joaovic-tech/IoT-Access-Control-ESP32/README.md

---
Project: IoT-Access-Control-ESP32
Description: INTERNET DAS COISAS (IOT) E INTELIGÊNCIA ARTIFICIAL APLICADA À DETECÇÃO E CLASSIFICAÇÃO DE ACESSOS EM AMBIENTES PÚBLICOS E PRIVADOS.
Purpose: TCC - Artigo científico
Acthor: João Victor Carvalho Alves
---





## 📌 Sobre o Projeto

Este repositório contém os artefatos de código e documentação técnica do meu Trabalho de Conclusão de Curso (TCC) em Engenharia de Software.

O projeto propõe uma solução de **Segurança Patrimonial Inteligente** utilizando IoT e Inteligência Artificial. Diferente de sistemas tradicionais que apenas gravam imagens, este sistema utiliza **Computação na Borda (Edge Computing)** e **Análise Contextual** para detectar, identificar e decidir sobre a permissão de acesso em tempo real.

### 🚀 Funcionalidades Principais

- **Detecção de Movimento (PIR):** Ativação inteligente para economia de energia e banda (Wake-on-Event).
- **Reconhecimento Facial:** Validação de identidade utilizando biblioteca `face_recognition` e OpenCV.
- **Motor de Regras (TBAC):** Controle de acesso baseado em horários e grupos (ex: Aluno Fundamental vs. Médio).
- **Comunicação MQTT:** Protocolo leve para transmissão de dados e imagens.

## 📂 Estrutura do Repositório (atual)

```bash
/
├── docs/              # Diagramas e Documentação Técnica
└── README.md
```

## 📄 Artigo Científico

O artigo completo detalhando a metodologia, resultados e fundamentação teórica estará disponível em breve.

- Status: 📝 Em escrita (Etapa de Desenvolvimento do Protótipo)
- Link: [Pendente - Aguardando Publicação](#)

## 📝 Licença

Este projeto é licenciado sob a licença [GPL-3.0 license](./LICENSE).
