joaovic-tech/IoT-Access-Control-ESP32/code/edge_manager/READE.md

# Edge Manager

Arquivo destinado ao código fonte do dispositivo IOT, compostos pelos seguintes periféricos:

1. ESP32-CAM
2. ESP32-CAM-MB
3. Sensor PIR
