joaovic-tech/IoT-Access-Control-ESP32/TCC_word/TCC_ALVES_EtapaFinal_2026.docx

# INTERNET DAS COISAS (IOT) E INTELIGÊNCIA ARTIFICIAL APLICADA À DETECÇÃO E CLASSIFICAÇÃO DE ACESSOS EM AMBIENTES PÚBLICOS E PRIVADOS

INTERNET OF THINGS (IOT) AND ARTIFICIAL INTELLIGENCE APPLIED TO THE DETECTION AND CLASSIFICATION OF ACCESSES IN PUBLIC AND PRIVATE ENVIRONMENTS

ALVES, João Victor Carvalho

FERRARI, Allan Christian Krainski

# Resumo

Este artigo apresenta o desenvolvimento e a análise de um protótipo de monitoramento e classificação de acessos que integra Internet das Coisas e reconhecimento facial. A pesquisa aplicada combina desenvolvimento experimental, inspeção da implementação e análise de registros de funcionamento. O dispositivo utiliza ESP32-CAM, câmera OV2640 e sensor PIR, com alimentação por baterias 18650 e conversor LM2596. O firmware transmite vídeo MJPEG diretamente ao aplicativo Android e envia quadros JPEG a um servidor local em Python, com FastAPI, OpenCV e face_recognition. O aplicativo, desenvolvido em Kotlin e Jetpack Compose, permite configurar câmeras, gerenciar pessoas e cômodos e consultar detecções. A identificação facial é estatística; a autorização por cômodo é calculada por regras determinísticas, com uma exceção quando o cômodo não é resolvido. As demonstrações registradas ilustram reconhecimento autorizado e não autorizado, rosto desconhecido e presença sem rosto identificável. Uma varredura histórica com um par genuíno e cinco pares impostores apresentou duas aceitações incorretas no limiar 0,60, sem permitir estimativas generalizáveis de desempenho. A versão implementada mantém limitações de autenticação, transporte sem cifragem, vivacidade opcional e ausência de gravação no cartão SD. Não foram estabelecidas medidas de latência fim a fim, autonomia ou custo total. Os resultados sustentam a demonstração funcional do protótipo e indicam a necessidade de ampliar a avaliação antes de sua utilização como mecanismo de segurança física.

Palavras-chave: internet das coisas; inteligência artificial; controle de acesso; reconhecimento facial; ESP32-CAM.

# Abstract

This article presents the development and analysis of an access monitoring and classification prototype that combines the Internet of Things and facial recognition. The applied research combines experimental development, implementation inspection, and analysis of operating records. The device uses an ESP32-CAM, an OV2640 camera, and a PIR sensor, powered by 18650 batteries and an LM2596 converter. Its firmware streams MJPEG video directly to an Android application and sends JPEG frames to a local Python server running FastAPI, OpenCV, and face_recognition. The application, developed with Kotlin and Jetpack Compose, supports camera configuration, people and room management, and detection monitoring. Facial identification is statistical, whereas room authorization follows deterministic rules, with an exception when the room cannot be resolved. Recorded demonstrations illustrate authorized and unauthorized recognized individuals, unknown faces, and presence without an identifiable face. A historical threshold sweep involving one genuine pair and five impostor pairs produced two incorrect acceptances at a threshold of 0.60, without supporting generalizable performance estimates. The implementation retains limitations involving authentication, unencrypted transport, optional liveness verification, and lack of SD card recording. End-to-end latency, battery life, and total cost have not been established. The results support a functional prototype demonstration and indicate that broader evaluation is required before deployment for physical security.

Keywords: internet of things; artificial intelligence; access control; facial recognition; ESP32-CAM.

# 1 INTRODUÇÃO

A segurança de ambientes físicos, sejam eles públicos ou privados, tem passado por uma transformação elevada nas últimas décadas. Historicamente dependente de barreiras físicas estáticas e da vigilância humana constante, o setor de segurança enfrenta agora o desafio de integrar tecnologias digitais emergentes para lidar com ameaças cada vez mais complexas e dinâmicas. A convergência entre a conectividade onipresente da Internet das Coisas (Internet of Things — IoT) e a capacidade analítica da Inteligência Artificial (IA) oferece uma oportunidade sem precedentes para redefinir os conceitos de monitoramento e controle de acesso.

Este trabalho enquadra-se na Revolução Industrial 4.0, na qual a digitalização dos processos físicos permite a criação de ambientes inteligentes (smart environments). O tema central é a aplicação de sistemas embarcados conectados e algoritmos de aprendizado de máquina para automatizar a detecção, identificação e classificação de indivíduos em pontos de acesso. Diferentemente dos sistemas de Circuito Fechado de Televisão (CFTV) tradicionais, que apenas registram eventos para análise forense posterior, a solução proposta busca uma abordagem proativa: identificar e classificar o acesso em tempo real, permitindo uma resposta imediata a potenciais riscos.

A problemática central reside nas limitações da vigilância visual contínua. A atenção do operador, as condições de observação e a quantidade de imagens influenciam a identificação de eventos. O estudo de Tickner e Poulton (1973) integra a discussão sobre monitoramento de imagens de vigilância. No controle de acesso, a automação pode apoiar a observação e a organização dos registros, mas acrescenta erros de percepção algorítmica que também precisam ser avaliados.

Diante deste cenário, este trabalho propõe o desenvolvimento e a análise de um dispositivo IoT integrado a um sistema de IA, capaz de monitorar entradas e saídas de forma autônoma. O objetivo geral é criar um protótipo funcional que realize a detecção de movimento, a captura de imagens e a classificação automática dos acessos entre pessoas reconhecidas, com autorização avaliada separadamente, e pessoas não reconhecidas, disponibilizando o resultado em tempo real ao responsável por meio de um aplicativo móvel. A proposta visa demonstrar que é possível elevar o nível de segurança e reduzir as falhas humanas através da automação tecnológica de baixo custo. Do ponto de vista econômico, sistemas de segurança biométrica comerciais costumam ter custos elevados, proibitivos para pequenas empresas ou residências populares; a utilização de hardware acessível como o ESP32-CAM democratiza o acesso a tecnologias de ponta. Do ponto de vista social e de segurança, a automação reduz o tempo de resposta a incidentes e mitiga o erro humano, proporcionando um monitoramento ininterrupto que não sofre de fadiga ou distração. Tecnicamente, o projeto justifica-se pela exploração da integração entre sistemas embarcados limitados e o processamento em servidor, um desafio relevante na engenharia de computação atual.

Para concretizar a proposta, foram delineados os seguintes objetivos específicos: fundamentar teoricamente os conceitos de IoT, IA, Visão Computacional e as normas da LGPD aplicáveis; desenvolver a arquitetura de hardware utilizando o módulo ESP32-CAM, o sensor PIR de presença e uma fonte autônoma composta por baterias 18650 e regulador LM2596; implementar o firmware de controle para captura de imagens e comunicação via protocolo HTTP, incluindo os servidores embarcados de API e de vídeo; desenvolver um servidor de processamento utilizando a linguagem Python, o framework FastAPI e as bibliotecas OpenCV e face_recognition para detecção e reconhecimento facial; construir um aplicativo Android em Kotlin para cadastro de pessoas, cadastro de cômodos, configuração dos dispositivos e acompanhamento das detecções; e analisar os resultados obtidos em termos de precisão, tempo de resposta e viabilidade, discutindo as implicações de segurança e privacidade.

Uma decisão de projeto merece destaque desde a introdução, por diferenciar este trabalho de implementações correntes: a decisão de autorizar ou negar o acesso não é tomada por um modelo de aprendizado de máquina. A IA atua exclusivamente na camada de percepção — reconhecer o rosto, verificar a vivacidade da captura, detectar a presença de alguém no quadro — e na camada de interface, por meio de um assistente em linguagem natural destinado ao administrador. A autorização propriamente dita é resolvida por uma tabela determinística, auditável e reproduzível. A seção 2.5 apresenta o fundamento dessa escolha e a seção 3.5.3 detalha sua implementação.

Este artigo está organizado em cinco seções. Após esta introdução, a seção 2 apresenta a Fundamentação Teórica, revisando a literatura sobre os pilares tecnológicos e legais do projeto. A seção 3, Metodologia, detalha os materiais, os métodos e a implementação prática do sistema. A seção 4, Resultados e Discussão, expõe os dados coletados nos testes em ambiente real e analisa o desempenho do sistema. Por fim, a seção 5 traz as Considerações Finais, sintetizando as conclusões e sugerindo trabalhos futuros.

# 2 FUNDAMENTAÇÃO TEÓRICA

A construção de um sistema de segurança inteligente exige a compreensão profunda de diversas áreas do conhecimento. Esta seção explora os conceitos de Internet das Coisas, Inteligência Artificial aplicada à visão, os paradigmas de segurança eletrônica, o arcabouço legal brasileiro de proteção de dados e, por fim, os limites do uso de modelos de linguagem em decisões críticas.

## 2.1 A revolução da Internet das Coisas (IoT)

A IoT não é apenas uma tendência tecnológica, mas uma mudança estrutural na forma como o mundo físico interage com o mundo digital.

### 2.1.1 Definições e conceitos acadêmicos

O termo foi cunhado por Kevin Ashton em 1999, mas o conceito evoluiu significativamente. Segundo Atzori, Iera e Morabito, em seu artigo seminal The Internet of Things: A Survey (Atzori et al., 2010), a IoT pode ser compreendida sob três visões: orientada a coisas (focada em sensores e etiquetas RFID), orientada à internet (focada em protocolos IP) e orientada à semântica (focada no significado dos dados). A definição consolidada refere-se a uma infraestrutura de rede global, na qual objetos físicos e virtuais são descobertos e integrados de forma transparente.

Dave Evans, em white paper para a Cisco, descreve a IoT como o ponto na história em que mais "coisas" ou objetos estavam conectados à Internet do que pessoas, estimando que bilhões de dispositivos estariam interconectados, gerando dados que poderiam "mudar tudo", desde a gestão urbana até a segurança pessoal (Evans, 2011).

### 2.1.2 Arquitetura de sistemas IoT

Para fins de segurança e vigilância, a arquitetura de IoT é geralmente dividida em camadas, conforme descrito na literatura técnica.

A Camada de Percepção (Perception Layer) constitui a base física do sistema, incluindo sensores como o PIR HC-SR501 e dispositivos de captura como a câmera OV2640 no ESP32-CAM. Sua função é coletar dados brutos do ambiente e transformá-los em sinais digitais.

A Camada de Rede (Network/Transport Layer) é responsável pela transmissão confiável dos dados coletados para o sistema de processamento, utilizando tecnologias como Wi-Fi, Bluetooth, Zigbee ou LoRaWAN. No contexto deste projeto, o foco é a transmissão de imagens via Wi-Fi sobre a pilha TCP/IP, com o protocolo HTTP na camada de aplicação.

A Camada de Processamento (Processing Layer) é onde os dados são armazenados e analisados, podendo ocorrer na nuvem (Cloud Computing) ou na borda (Edge Computing). Neste trabalho adotou-se uma posição intermediária — um servidor local na própria rede da residência —, escolha crítica para a segurança, pois reduz a latência, elimina a dependência de conectividade externa constante e mantém o dado biométrico dentro do perímetro do titular, ponto que a seção 2.4 retoma sob a ótica da LGPD.

A Camada de Aplicação (Application Layer) representa a interface com o usuário final, na qual os alertas são recebidos e as decisões são tomadas. Neste projeto, essa camada é o aplicativo Android descrito na seção 3.6.

### 2.1.3 Protocolos de comunicação: o modelo requisição-resposta do HTTP

A escolha do protocolo de comunicação é crucial para a eficiência do sistema.

O protocolo HTTP (Hypertext Transfer Protocol) é amplamente utilizado para transmissão de imagens e streaming de vídeo (MJPEG) devido à sua simplicidade e à compatibilidade nativa com navegadores web e com bibliotecas cliente de praticamente qualquer linguagem. Sua principal desvantagem reconhecida na literatura é o overhead de cabeçalho e o custo de estabelecer conexões TCP quando elas não são reutilizadas, o que pode aumentar a latência e o consumo de energia em cenários de envio muito frequente. Estudos comparativos entre protocolos de IoT registram, para cargas pequenas e periódicas, vantagem do modelo publica-assina sobre o modelo requisição-resposta (Amirkhanov et al., 2025; Flespi Platform, 2017).

Esse overhead, entretanto, precisa ser avaliado contra o padrão de tráfego real da aplicação. O sistema descrito neste trabalho não transmite telemetria contínua de poucos bytes: ele transmite um quadro JPEG completo por evento de presença, com intervalo mínimo de dez segundos entre disparos, e um fluxo de vídeo contínuo que é, por natureza, uma única resposta HTTP longa. Nesse regime, o custo relativo do cabeçalho tende a ser menor diante do payload da imagem, embora não tenha sido quantificado no protótipo, e as vantagens do HTTP passam a predominar:

- Transporte nativo de cargas binárias grandes. O envio da imagem usa multipart/form-data, formato que o servidor decodifica sem qualquer protocolo de fragmentação e remontagem escrito manualmente.

- Vídeo ao vivo sem intermediários. O streaming MJPEG é uma resposta multipart/x-mixed-replace mantida aberta pelo próprio dispositivo. O aplicativo consome o fluxo diretamente do ESP32-CAM, sem que o vídeo trafegue pelo servidor de reconhecimento — o que mantém a latência da imagem ao vivo dependente apenas da rede local.

- Contrato explícito e inspecionável. Cada operação é uma rota com método, parâmetros e resposta definidos, verificável com um cliente HTTP comum durante o desenvolvimento e a depuração.

- Ausência de um componente intermediário. O modelo publica-assina exige um broker — um terceiro processo que precisa estar instalado, configurado, em execução e disponível para que qualquer mensagem trafegue. Em uma instalação residencial, esse componente adicional representa mais um ponto de falha e mais uma superfície de configuração.

- Comunicação bidirecional imediata. O acionamento do relé de acesso, o controle do LED de iluminação e a leitura do estado do dispositivo são requisições dirigidas ao ESP32-CAM, que responde de imediato, sem necessidade de tópicos separados de comando e de retorno.

Por essas razões, este trabalho adota o HTTP em toda a comunicação entre as três camadas do sistema. A seção 3 detalha as rotas, os métodos, os payloads e as portas efetivamente implementados.

Não foi realizada medição de latência fim a fim do protótipo. Tempos de outros estudos não substituem a medição entre o disparo do PIR e o registro da detecção.

## 2.2 Inteligência Artificial e Visão Computacional

A integração da IA transforma câmeras passivas em sensores inteligentes capazes de "entender" a cena.

### 2.2.1 Conceitos de IA segundo Russell e Norvig

Stuart Russell e Peter Norvig, em sua obra clássica Artificial Intelligence: A Modern Approach (Russell; Norvig, 2010), definem IA não apenas como a simulação da inteligência humana, mas como o estudo de agentes racionais. Um agente é qualquer coisa que percebe seu ambiente via sensores e age sobre esse ambiente através de atuadores.

No contexto deste projeto, o sistema de segurança é um "agente racional" que percebe a presença (sensor PIR), captura o estado do mundo (câmera OV2640) e age (aciona o relé da trava ou registra o evento no histórico) para maximizar sua medida de desempenho (segurança e conveniência).

### 2.2.2 Processamento digital de imagens e Visão Computacional

A Visão Computacional é a subárea da IA que lida com a interpretação de dados visuais. Segundo Gonzalez e Woods (2010), em Processamento Digital de Imagens, o processo pode ser dividido em fases fundamentais: aquisição da imagem, que ocorre via captura pelo sensor OV2640; pré-processamento, referente à melhoria da imagem (ajuste de brilho e contraste, conversão de espaço de cor, redimensionamento) para facilitar a análise; segmentação, que corresponde ao isolamento dos objetos de interesse — neste caso, a face — do fundo da imagem; representação e descrição, relativa à extração de características (features) que tornam aquele objeto único; e reconhecimento e interpretação, que consiste na atribuição de um rótulo (identidade) ao objeto com base em seus descritores.

Richard Szeliski, em Computer Vision: Algorithms and Applications (Szeliski, 2010), complementa que os algoritmos modernos de visão dependem fortemente de aprendizado de máquina estatístico para realizar o reconhecimento robusto em ambientes não controlados (variações de luz, pose e expressão). Essa dependência tem consequência prática direta neste trabalho: como a seção 4.6 documenta, a orientação física com que a câmera é instalada altera o resultado do detector, porque os modelos foram treinados sobre rostos aproximadamente verticais.

### 2.2.3 Algoritmos de detecção e reconhecimento facial

Para a execução prática, é essencial distinguir entre detecção e reconhecimento. A detecção facial consiste em encontrar onde está o rosto na imagem. O algoritmo de Viola e Jones (2001), baseado em cascatas de classificadores sobre características de Haar, é um método clássico, extremamente rápido e leve, adequado para pré-processamento, embora propenso a falsos positivos em cenários complexos. Redes Neurais Convolucionais (CNNs), como o MTCNN ou modelos baseados em YOLO (You Only Look Once), oferecem precisão superior, detectando faces em diversos ângulos e escalas, mas exigem maior poder computacional.

Uma alternativa de custo intermediário é o detector baseado em Histograma de Gradientes Orientados (HOG) implementado na biblioteca Dlib (King, 2009), adotado neste trabalho. Ele é substancialmente mais robusto que as cascatas de Haar e ordens de magnitude mais barato que um detector neural executado em CPU — característica decisiva para um servidor doméstico sem GPU, conforme a medição comparativa apresentada na seção 3.5.2.

O reconhecimento facial, por sua vez, busca identificar quem é a pessoa. Métodos tradicionais como Eigenfaces (PCA) e Fisherfaces (LDA) foram amplamente substituídos por modelos de aprendizado profundo como o FaceNet (Schroff et al., 2015) ou a rede residual da Dlib. Esta última mapeia uma face em um vetor de 128 dimensões, no qual a distância euclidiana entre vetores corresponde à dissimilaridade facial, alcançando acurácia superior a 99% no benchmark Labeled Faces in the Wild (LFW). É importante registrar, contudo, que essa acurácia é obtida sobre um conjunto de avaliação padronizado e não se transfere automaticamente para um sistema instalado em campo, com poucas amostras por pessoa e iluminação não controlada — ponto que a seção 4.4 documenta com medições próprias.

## 2.3 Segurança eletrônica e controle de acesso

O controle de acesso físico visa garantir que apenas pessoas autorizadas entrem em um determinado espaço.

### 2.3.1 Paradigma de segurança física e "Defesa em Profundidade"

A segurança patrimonial baseia-se no conceito de "Defesa em Profundidade" (Defense in Depth), que prega a utilização de múltiplas camadas de segurança redundantes. O controle de acesso automatizado atua como uma barreira de triagem crítica. Diferentemente de chaves físicas, que podem ser copiadas, ou de cartões RFID, que podem ser roubados, a biometria facial vincula o acesso intrinsecamente ao indivíduo, elevando o nível de segurança (fator "o que você é" vs. "o que você tem").

O princípio da defesa em profundidade orienta a combinação de reconhecimento facial, autorização cadastral e restrição por cômodo. No protótipo, entretanto, a verificação de vivacidade é opcional e vem desabilitada; quando não produz um resultado, não impede a autorização. A ausência de um cômodo resolvido também preserva a chave mestra de autorização. Essas exceções impedem afirmar que todas as camadas precisam aprovar explicitamente cada acesso.

### 2.3.2 Métricas de desempenho biométrico

A eficácia de um sistema biométrico é avaliada estatisticamente. O FAR (False Acceptance Rate) representa a probabilidade de o sistema aceitar incorretamente uma pessoa não autorizada; em segurança, o objetivo primário é minimizar o FAR. O FRR (False Rejection Rate) representa a probabilidade de o sistema rejeitar incorretamente uma pessoa autorizada; um FRR alto causa inconveniência e frustração ao usuário. A Curva ROC (Receiver Operating Characteristic) representa graficamente a relação entre a taxa de verdadeiros positivos e a de falsos positivos. O ajuste do limiar de sensibilidade (threshold) do algoritmo move o sistema ao longo dessa curva, trocando conveniência (baixo FRR) por segurança (baixo FAR). O ponto em que as duas taxas se igualam é denominado EER (Equal Error Rate) e é frequentemente usado como número-resumo de um sistema biométrico.

Este trabalho realizou uma varredura empírica de limiar sobre as próprias amostras cadastradas, cujos resultados — e cujas limitações estatísticas — são apresentados na seção 4.4.

## 2.4 Aspectos legais: a LGPD e o tratamento de biometria

A implementação tecnológica não ocorre no vácuo jurídico. No Brasil, a Lei Geral de Proteção de Dados (Lei nº 13.709/2018) impõe diretrizes estritas.

A LGPD define dados biométricos — como a imagem facial utilizada para identificação única — como dados pessoais sensíveis (Art. 5º, II). O tratamento desses dados é vedado, exceto em hipóteses específicas (Art. 11), como:

- quando o titular ou seu responsável legal consentir, de forma específica e destacada, para finalidades específicas;

- sem fornecimento de consentimento, nas hipóteses de garantia da prevenção à fraude e à segurança do titular, nos processos de identificação e autenticação de cadastro em sistemas eletrônicos (Art. 11, II, "g").

A implantação requer definir finalidade e base legal aplicável, assegurar transparência e adotar medidas de segurança compatíveis com o tratamento de dados sensíveis. O art. 38 prevê que a ANPD pode determinar a elaboração de Relatório de Impacto à Proteção de Dados Pessoais (RIPD); não estabelece uma obrigação universal e automática para qualquer condomínio ou empresa. A escolha da base legal exige avaliar as condições do tratamento, sem presumir que o consentimento seja sempre a única hipótese admitida (Brasil, 2018).

Na configuração local, as amostras e os registros são persistidos em arquivos no computador servidor. Existe, contudo, uma integração opcional com Telegram que envia a fotografia e sua legenda a um serviço externo quando configurada. A localização do servidor, por si só, não assegura conformidade: é necessário considerar retenção, descarte, controle de acesso, publicação de imagens e eventuais transferências de dados.

O tráfego entre ESP32-CAM, servidor e aplicativo utiliza HTTP sem TLS. Isso descreve a implementação adotada, sem demonstrar impossibilidade técnica de cifragem no hardware. As rotas do servidor não implementam autenticação de administrador; no firmware, a proteção por token cobre apenas determinadas rotas de atuação e pode estar desabilitada. O armazenamento local e as regras de autorização não substituem a proteção das interfaces administrativas.

## 2.5 Análise contextual e os limites do uso de modelos de linguagem em decisões de acesso

Enquanto a Visão Computacional, discutida anteriormente, resolve o problema da percepção (identificar quem está no ambiente), a segurança moderna exige uma camada superior de inteligência capaz de interpretar o contexto (analisar se a presença daquele indivíduo é permitida naquele momento e local).

Segundo Russell e Norvig (2010), um agente inteligente não apenas percebe o ambiente através de sensores, mas atua sobre ele para alcançar um objetivo. No contexto deste trabalho, o "objetivo" é a segurança patrimonial. Para isso, o sistema deve operar não apenas com reconhecimento de padrões, mas também com inferência lógica e regras de conhecimento. Transformar o dado bruto ("rosto de João detectado") em informação semântica ("João, cujo cadastro libera apenas o próprio quarto, foi detectado na sala privada") permite aplicar restrições por local, pois o sistema passa a validar a detecção contra um conjunto de regras, aproximando-se do conceito de Computação Ciente de Contexto (Context-Aware Computing).

A questão relevante — e que constitui uma contribuição própria deste trabalho — é qual mecanismo deve produzir essa inferência. Uma versão anterior do sistema derivava a regra de acesso de uma observação em texto livre digitada no cadastro, interpretada por um modelo de linguagem executado localmente. O desenho foi abandonado após medição registrada durante o desenvolvimento: para a observação "Quarto do Antônio", o modelo respondeu com um campo de acesso total verdadeiro, o que liberaria aquela pessoa na casa inteira. Não se trata de defeito de um modelo específico, mas de uma incompatibilidade de natureza entre a ferramenta e a tarefa. Um controle de acesso físico exige que a mesma entrada produza sempre a mesma saída, que a regra vigente seja legível por um auditor humano e que a falha, quando ocorrer, ocorra no sentido restritivo. A geração de texto não constitui, por si só, uma garantia de observância dessas condições; por isso, a interpretação em linguagem natural foi retirada da decisão de acesso.

Adota-se, portanto, uma separação explícita de responsabilidades, que atravessa todo o restante deste artigo:

- A IA percebe. Reconhecimento facial, verificação de vivacidade e detecção de presença — tarefas estatísticas por natureza, nas quais o erro é inevitável e mensurável por FAR e FRR.

- A IA conversa. Um assistente em linguagem natural traduz perguntas do administrador em consultas ao histórico ou em propostas de mudança de configuração, submetidas à confirmação na interface antes de serem enviadas à API de aplicação de propostas.

- A IA não autoriza. A decisão de permitir ou negar um acesso é uma tabela determinística, apresentada na seção 3.5.3, que torna a regra explícita, mas não elimina falsas aceitações biométricas, falhas de configuração ou acesso indevido às APIs.

Essa arquitetura preserva o ganho semântico pretendido pela análise contextual sem transferir a um componente probabilístico a responsabilidade por uma decisão de consequência física irreversível.

# 3 METODOLOGIA

Esta seção descreve como o sistema foi efetivamente construído. Inicia pela visão geral da arquitetura e pelo diagrama de blocos que relaciona as três camadas (3.1); apresenta em seguida os materiais empregados no protótipo físico, com o detalhamento do módulo ESP32-CAM, do sensor PIR e do subsistema de alimentação autônoma (3.2); descreve o fluxo de dados que vai do disparo de presença até o veredito de acesso (3.3); detalha o firmware embarcado, incluindo a configuração da câmera, os dois servidores HTTP e a tarefa assíncrona de envio (3.4); apresenta o servidor de reconhecimento, seu contrato de rotas, o pipeline de visão computacional, o motor determinístico de decisão e os módulos complementares (3.5); descreve o aplicativo Android e suas telas (3.6); e encerra com o procedimento adotado nos testes (3.7).

Quanto à natureza, esta é uma pesquisa aplicada, de abordagem qualitativa e quantitativa, conduzida pelo método de desenvolvimento experimental: constrói-se um artefato funcional e observa-se seu comportamento em ambiente real, registrando medições sempre que o instrumental disponível permitiu.

## 3.1 Visão geral da arquitetura

A solução foi desenvolvida sobre uma arquitetura de IoT em três camadas: a Camada de Borda, responsável pela detecção de presença, captura e transmissão da imagem; a Camada de Servidor, responsável pelo processamento de Visão Computacional, pela persistência dos dados e pela decisão de acesso; e a Camada de Aplicação, o aplicativo Android que serve de painel de monitoramento e de interface de cadastro.

O fluxo foi projetado para minimizar a latência percebida pelo usuário e para manter o dado biométrico dentro da rede local. Duas decisões estruturais decorrem disso:

1. O vídeo ao vivo não passa pelo servidor Python. O aplicativo abre a conexão MJPEG diretamente contra o ESP32-CAM, na porta 81. O servidor de reconhecimento só recebe quadros isolados, quando há um evento a analisar.

2. O reconhecimento não ocorre na borda. A implementação não executa o modelo facial da Dlib no ESP32-CAM; o trabalho pesado é delegado ao servidor local, que dispõe de CPU e memória convencionais.

A Figura 1 apresenta o diagrama de blocos do sistema, com os protocolos e as portas de cada enlace.

Figura 1 – Diagrama de blocos da arquitetura do sistema

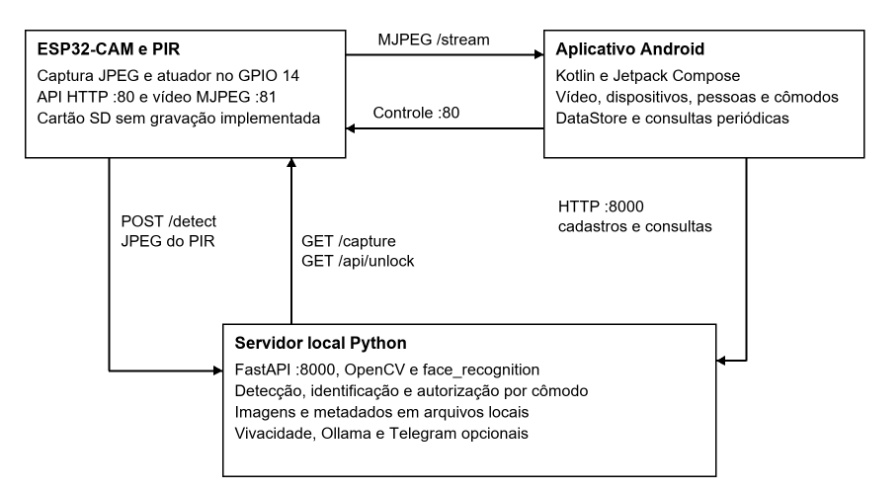
[picture p4: figure]

Fonte: o autor (2026).

## 3.2 Materiais: o hardware do protótipo

O protótipo foi montado com componentes de prateleira, de baixo custo e disponibilidade nacional. Esta subseção descreve cada um deles e o papel que desempenha no conjunto.

### 3.2.1 Módulo ESP32-CAM e gravador ESP32-CAM-MB

O núcleo do dispositivo é o módulo ESP32-CAM, na variante AI-Thinker. Trata-se de uma placa que reúne, em pouco mais de 27 × 40,5 mm, o microcontrolador ESP32 — SoC de dois núcleos com rádio Wi-Fi 802.11 b/g/n e Bluetooth integrados —, memória PSRAM externa, um conector para módulo de câmera, um leitor de cartão microSD e um LED branco de alta intensidade utilizável como iluminação auxiliar. As Figuras 2 e 3 mostram as duas faces da placa efetivamente utilizada.

Figura 2 – Módulo ESP32-CAM — face da câmera OV2640 e do LED de iluminação

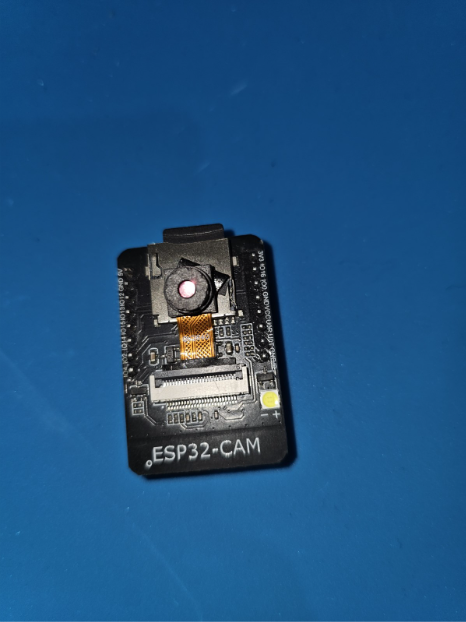
[picture p5: figure]

Fonte: o autor (2026).

Figura 3 – Módulo ESP32-CAM — face do módulo ESP32-S e da antena impressa

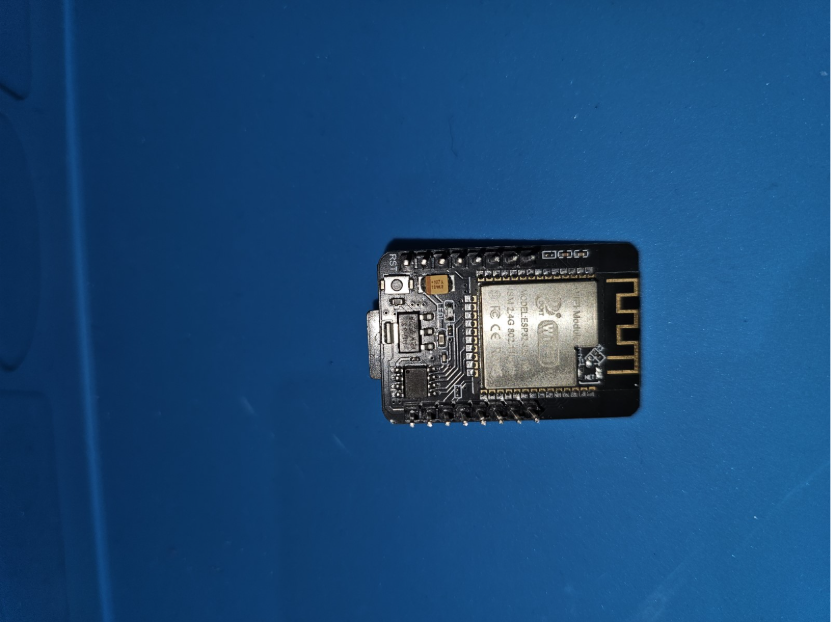
[picture p6: figure]

Fonte: o autor (2026).

A PSRAM é utilizada para os buffers de imagem e, preferencialmente, para o corpo multipart. Quando não é detectada, a configuração inicial solicita QVGA, um buffer em DRAM, qualidade JPEG 15 e captura CAMERA_GRAB_WHEN_EMPTY. Contudo, após inicializar o sensor, o código chama set_framesize(FRAMESIZE_VGA) incondicionalmente. Portanto, o retorno a QVGA não fica preservado ao final da inicialização, e a operação sem PSRAM precisa ser corrigida e validada antes de ser apresentada como modo degradado garantido.

A gravação do firmware é feita através da placa adaptadora ESP32-CAM-MB, que acopla-se ao ESP32-CAM pelos pinos de borda e fornece um conversor USB-serial CH340 e o circuito de auto-reset, dispensando o curto manual entre IO0 e GND a cada gravação. A Figura 4 mostra o conjunto montado.

Figura 4 – ESP32-CAM acoplado à placa gravadora ESP32-CAM-MB

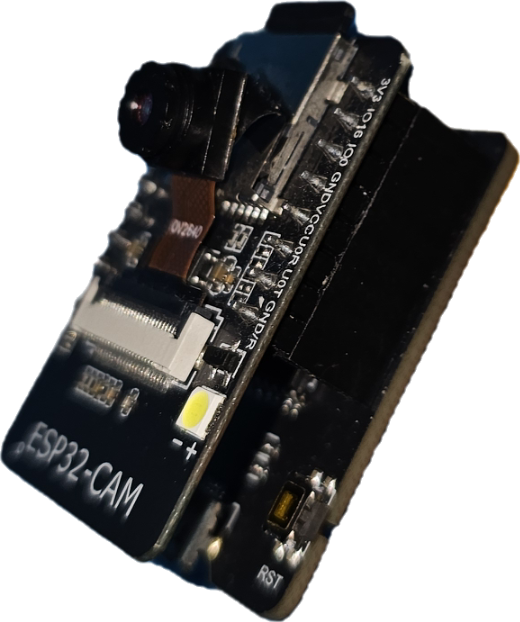
[picture p7: figure]

Fonte: o autor (2026).

O sensor de imagem é o OV2640, um sensor CMOS de 2 megapixels com compressão JPEG em hardware. A compressão embarcada é a razão pela qual um microcontrolador consegue transmitir vídeo: o quadro chega ao firmware já codificado, sem que a CPU precise realizar a compressão em software.

### 3.2.2 Sensor de presença PIR

A detecção de movimento é feita por um sensor PIR (Passive InfraRed), no formato do módulo HC-SR501. O sensor não emite energia: ele mede a radiação infravermelha do ambiente através de um elemento piroelétrico dividido em duas metades, sob uma lente de Fresnel que segmenta o campo de visão em zonas. Quando um corpo com temperatura distinta do fundo — tipicamente uma pessoa — atravessa a fronteira entre duas zonas, as metades do elemento recebem irradiâncias diferentes e a diferença de sinal é interpretada como movimento, elevando a saída digital do módulo a nível alto. A Figura 5 mostra o componente.

Figura 5 – Sensor de movimento e presença PIR

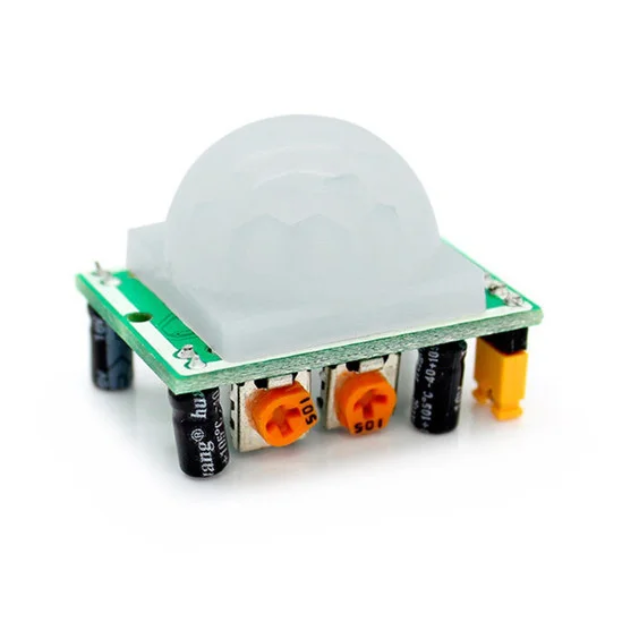
[picture p8: figure]

Fonte: https://www.eletrogate.com/sensor-de-movimento-presenca-pir. Acesso em: 30 ago. 2026.

A escolha do PIR como gatilho, em vez de análise contínua de vídeo, é uma decisão de eficiência: o reconhecimento facial só é executado quando há motivo físico para supor que existe alguém no ambiente, o que evita processamento e tráfego permanentes.

O sensor é ligado ao GPIO 13 do ESP32-CAM. Essa escolha de pino não é arbitrária e corrige um defeito observado em versão anterior do protótipo: o sensor estava declarado no firmware como GPIO 3, que no ESP32 corresponde ao pino RX0 da UART. Com a comunicação serial ativa para depuração, qualquer ruído elétrico na linha ou qualquer byte chegando pelo cabo USB era lido pelo código como transição do sensor, gerando disparos falsos e envios de imagem sem que houvesse ninguém no ambiente. A alteração remove a sobreposição entre o sinal do PIR e a recepção serial; não foi localizada uma série de medições que quantifique a eliminação de disparos falsos.

### 3.2.3 Alimentação: baterias 18650 e regulador LM2596

Para que o dispositivo não dependa de tomada, o protótipo é alimentado por duas células de íon-lítio 18650 montadas em suporte, com tensão nominal de 3,7 V e tensão de plena carga de 4,2 V por célula. Associadas em série, entregam entre 6,0 V e 8,4 V conforme o estado de carga — faixa que não pode ser aplicada diretamente ao ESP32-CAM.

A adequação de tensão é feita por um regulador *step-down* (*buck*) ajustável LM2596 DC-DC, mostrado na Figura 6. Trata-se de um conversor comutado que reduz a tensão de entrada a um valor de saída ajustável por trimpot, com capacidade nominal de até 3 A para o circuito integrado, condicionada ao dimensionamento e à dissipação do módulo. Duas propriedades justificam a escolha em vez de um regulador linear: a possibilidade de maior eficiência que a regulação linear — enquanto um regulador linear dissiparia a diferença de tensão inteiramente em calor, reduzindo drasticamente a autonomia das células —, e a estabilidade da saída ao longo da descarga, desde que exista margem entre a tensão de entrada e a saída ajustada; a regulação em toda a faixa de descarga não foi medida.

Figura 6 – Regulador de tensão ajustável LM2596 DC-DC

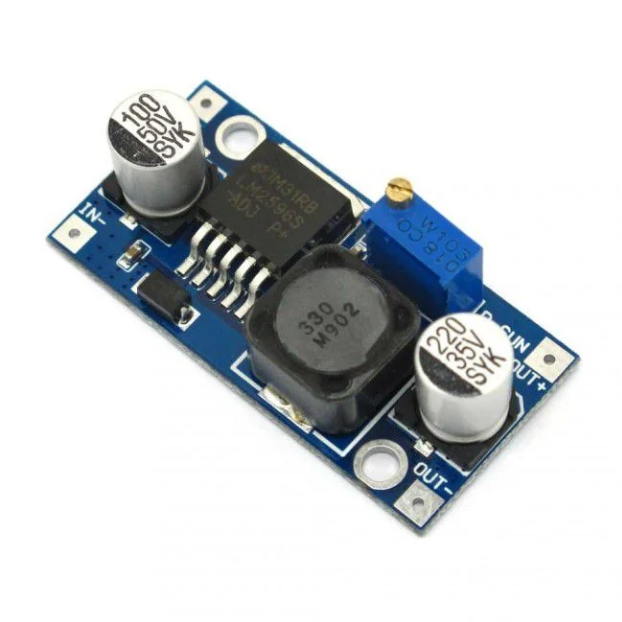
[picture p9: figure]

Fonte: https://www.eletrogate.com/modulo-regulador-de-tensao-step-down-lm2596. Acesso em: 30 ago. 2026.

A estabilidade da alimentação é requisito crítico e não apenas conveniência: o pico de corrente exigido pelo rádio Wi-Fi durante a transmissão é a causa mais comum de reinicializações espúrias em projetos com ESP32-CAM, e uma fonte incapaz de sustentá-lo produz falhas intermitentes de difícil diagnóstico.

A tensão efetivamente ajustada, a capacidade das células e a autonomia não foram medidas; a descrição do subsistema não estabelece desempenho energético.

### 3.2.4 Atuador de acesso e montagem

A liberação física é feita por um módulo de relé, comandado pelo GPIO 14. Também aqui a escolha do pino resolve um problema concreto: o GPIO 12 do ESP32 é um strapping pin (MTDI), lido durante a inicialização para definir a tensão de operação da memória flash. Com o relé conectado a ele, o nível presente no momento do boot impedia a placa de inicializar. O GPIO 14, correspondente ao sinal HS2_CLK do leitor de cartão — não inicializado pelo firmware atual —, não tem essa função de configuração e pode assumir qualquer nível durante a partida sem consequências.

Embora exista um cartão microSD de 2 GB instalado no ESP32-CAM, o firmware não inicializa SD ou SD_MMC e não grava vídeo ou eventos nesse cartão. Os GPIOs 13 e 14 utilizados pelo PIR e pelo relé também participam da interface SD_MMC, exigindo revisão da pinagem para acrescentar armazenamento. O vídeo atual é transmitido por MJPEG; o servidor persiste imagens isoladas com metadados. Transmissão ao vivo e gravação contínua são funcionalidades distintas.

O Quadro 1 consolida a pinagem do protótipo.

Quadro 1 – Pinagem do dispositivo IoT

Função | GPIO | Observação
Sensor PIR (saída digital) | 13 | Entrada, com debounce de 50 ms por software
Relé / trava de acesso | 14 | Evitado o GPIO 12 por ser strapping pin (MTDI)
LED branco de iluminação (flash) | 4 | Controlado por PWM (ledcWrite), intensidade 0–255
LED vermelho embutido | 33 | Active low; sinaliza o estado da conexão Wi-Fi

Fonte: o autor (2026).

As Figuras 7 e 8 mostram o protótipo montado. A montagem utiliza uma protoboard como base de interligação, com o sensor PIR fixado a uma haste de madeira por abraçadeiras, de modo a posicionar o elemento sensor acima do plano da placa e ampliar seu campo de visão. Na face posterior ficam o suporte das duas células 18650 e o módulo LM2596.

Figura 7 – Protótipo montado — vista frontal

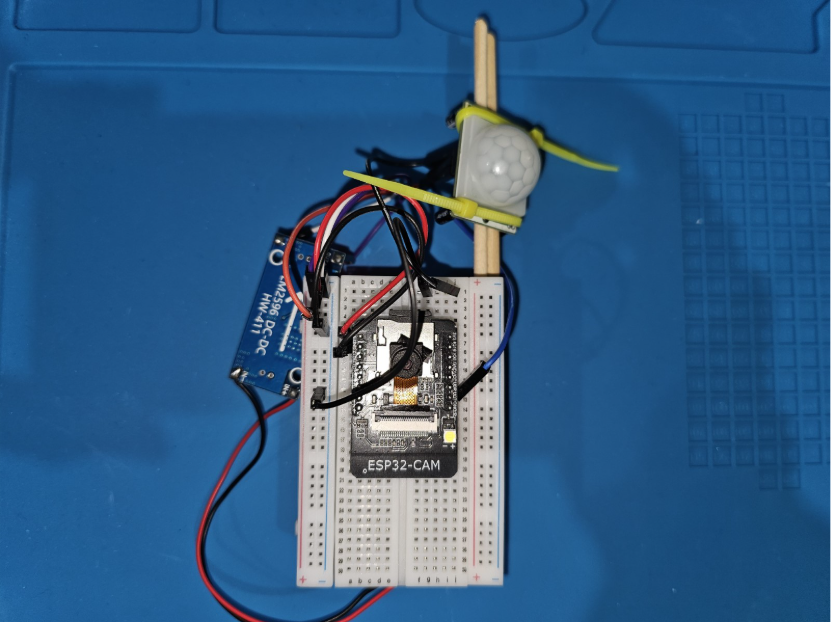
[picture p10: figure]

Fonte: o autor (2026).

Figura 8 – Protótipo montado — vista traseira, com o subsistema de alimentação

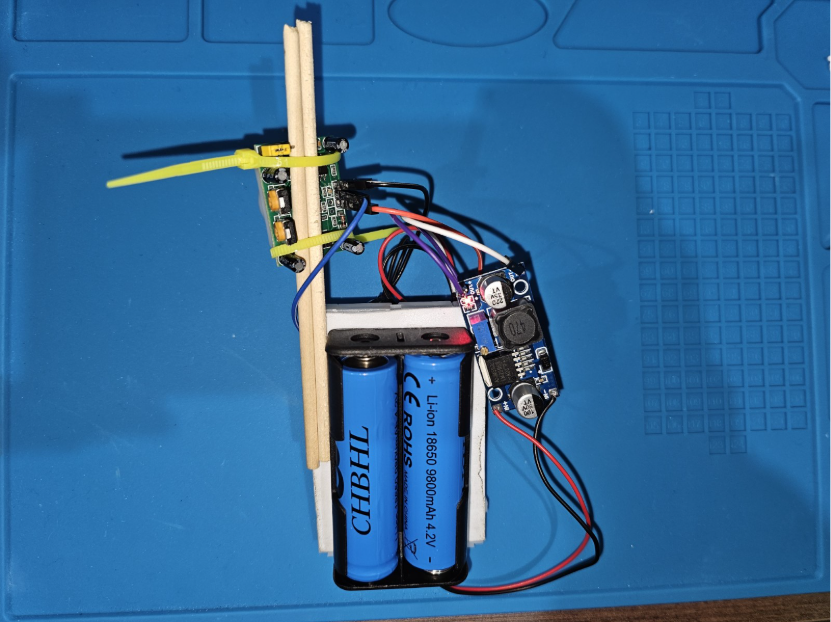
[picture p11: figure]

Fonte: o autor (2026).

Cabe registrar que se trata de uma montagem de bancada, destinada à validação funcional. Um encapsulamento definitivo, com fixação mecânica e proteção contra poeira e umidade, é apontado na seção 5 entre os trabalhos futuros.

## 3.3 Fluxo de dados e funcionamento

O funcionamento do sistema segue um fluxo determinístico, composto pelas etapas descritas a seguir.

1. Detecção de presença. O sensor PIR detecta variação de irradiância infravermelha e eleva a saída ligada ao GPIO 13. O laço principal do firmware amostra o pino continuamente e aplica debounce de 50 ms, contabilizando apenas as transições estáveis de nível baixo para alto (borda de subida).

2. Enfileiramento da captura. Reconhecida a borda de subida, e respeitado um intervalo de guarda de 10 segundos desde o último envio, o firmware sinaliza uma tarefa dedicada do FreeRTOS. O laço principal não executa a captura nem a requisição de rede, para não bloquear o atendimento do streaming de vídeo e das rotas de API.

3. Captura e montagem da requisição. A tarefa dedicada solicita um quadro à câmera, já codificado em JPEG pelo sensor OV2640, e monta em memória um corpo multipart/form-data contendo o campo source (com o valor pir, que identifica a origem do evento) e o campo file (a imagem, declarada como image/jpeg). A alocação é tentada preferencialmente na PSRAM, com recuo para a memória interna.

4. Transmissão. A tarefa executa POST /detect contra o endereço do servidor, com tempo limite de 5 segundos para conexão e para leitura. O código de resposta HTTP é armazenado e fica disponível na rota de estado do dispositivo, permitindo diagnosticar falhas de comunicação a partir do aplicativo.

5. Recepção e normalização. O servidor recebe o arquivo e aplica a rotação configurada ao quadro antes de qualquer análise. Essa etapa é indispensável quando a câmera está montada fora da vertical, pelas razões documentadas na seção 4.6.

6. Identificação. O servidor detecta os rostos presentes no quadro, extrai o vetor de características de cada um e compara-o com os vetores das amostras cadastradas, atribuindo a identidade cujo vetor apresenta a menor distância euclidiana, desde que abaixo do limiar configurado.

7. Decisão de acesso. Identificada a pessoa, o servidor consulta o cômodo vigiado por aquela câmera e o confronta com a lista de cômodos liberados no cadastro, aplicando a tabela determinística descrita na seção 3.5.3.

8. Registro. Quando o pipeline conclui normalmente — com rosto reconhecido, desconhecido, presença sem rosto legível ou quadro vazio —, a imagem é gravada em disco com carimbo de data e hora, acompanhada de um arquivo de metadados, e uma linha estruturada é emitida no log do servidor.

9. Ação e notificação. Se o rosto selecionado permanece autorizado após as verificações aplicáveis, e se a liberação automática estiver habilitada, o servidor chama a rota de destravamento no ESP32-CAM, que aciona o relé por três segundos. Em qualquer caso, a detecção passa a constar do histórico exibido no aplicativo.

Existe ainda um caminho alternativo de acionamento: o usuário pode solicitar uma verificação imediata pelo botão Escanear ambiente do aplicativo. Nesse caso o servidor busca um quadro em GET /capture no dispositivo e executa exatamente o mesmo pipeline, com a origem registrada como scan. Foi esse o caminho utilizado nos testes práticos da seção 4.3, por permitir controlar o instante da captura.

## 3.4 Desenvolvimento do firmware (borda)

O firmware do dispositivo IoT foi desenvolvido em C++ sobre o core ESP32 para o ambiente Arduino, e compila para a placa esp32:esp32:esp32cam. O código prioriza a responsividade da rede e a robustez a falhas de conectividade.

### 3.4.1 Configuração da câmera

Utilizou-se a biblioteca esp_camera.h para configurar o sensor OV2640. Para equilibrar a qualidade necessária ao reconhecimento facial com a velocidade de transmissão, o formato de pixel foi definido como JPEG, a resolução como VGA (640 × 480) e o fator de qualidade como 12 — numa escala de 0 a 63 em que valores menores significam melhor qualidade e arquivos maiores. O relógio do sensor opera a 20 MHz.

Dois parâmetros merecem nota. O modo de captura é CAMERA_GRAB_LATEST, que descarta quadros acumulados e sempre entrega o mais recente, evitando que o vídeo ao vivo acumule atraso progressivo. E o número de buffers é dois, alocados em PSRAM, o que permite que um quadro esteja sendo transmitido enquanto o seguinte é capturado. A configuração inicial sem PSRAM usa um buffer em DRAM e outro modo de captura, mas a resolução volta a VGA em uma chamada posterior, conforme a limitação descrita na seção 3.2.1.

A resolução VGA foi mantida também para o envio ao servidor. Trata-se de escolha deliberada: como a seção 3.5.2 demonstra, imagens muito maiores aumentam o tempo de detecção proporcionalmente à área, sem aumentar a quantidade de rostos detectados no ensaio descrito; isso não demonstra equivalência de reconhecimento em qualquer cenário.

### 3.4.2 Servidores HTTP embarcados

O firmware inicializa dois servidores HTTP independentes sobre a pilha esp_http_server:

- Porta 80 — atende o painel web embarcado, a captura de quadro único e as rotas de API consumidas pelo aplicativo e pelo servidor Python.

- Porta 81 — atende exclusivamente o streaming MJPEG, servido como uma resposta multipart/x-mixed-replace que permanece aberta indefinidamente.

A separação em duas portas é necessária porque o streaming ocupa um manipulador de conexão por tempo indeterminado; mantê-lo no mesmo servidor das rotas de controle impediria que o dispositivo respondesse a um comando de destravamento enquanto o vídeo estivesse sendo assistido. Registre-se, como limitação desta implementação síncrona, que o servidor atende um único cliente de *stream* por vez.

O Quadro 2 apresenta o contrato de rotas exposto pelo dispositivo.

Quadro 2 – Rotas HTTP expostas pelo ESP32-CAM

Rota | Porta | Método | Resposta
/stream | 81 | GET | multipart/x-mixed-replace (fluxo MJPEG contínuo)
/capture | 80 | GET | JPEG único
/api/status | 80 | GET | JSON com status, fw, ip, rssi, uptime_s, flash, flash_duty, relay, pir, pir_count, free_heap, free_psram, has_psram, framesize, quality, fps, stream_clients, detect_busy, detect_last_status
/api/flash?state=1|0 | 80 | GET | {success, flash, duty}
/api/relay?state=1|0 ou ?pulse=<ms> | 80 | GET | {success, relay}
/api/unlock | 80 | GET | {success, message, relay} — pulso de 3 s no relé
/api/scan | 80 | GET | {queued, busy, last_status} — força captura e POST /detect
/ | 80 | GET | Painel web embarcado

Fonte: o autor (2026), a partir do código-fonte em code/CameraWebServer/app_httpd.cpp.

As rotas de atuação (flash, relay, unlock) aceitam um parâmetro key com um token compartilhado. Quando a macro correspondente não está definida no arquivo de segredos, a verificação é desativada — uma limitação de proteção. O cliente Python oferece suporte ao token, enquanto o cadastro de dispositivos e as chamadas de atuação do aplicativo atual não acrescentam esse parâmetro. Habilitá-lo exige compatibilizar também o aplicativo.

### 3.4.3 Envio da detecção ao servidor

O envio da imagem ao servidor de reconhecimento é executado por uma tarefa dedicada do FreeRTOS, fixada no núcleo 0 e criada com pilha de 6 KiB. O laço principal apenas sinaliza um pedido; a tarefa é quem captura o quadro, monta o corpo multipart e executa a requisição HTTP.

Essa separação é um requisito de projeto e não um detalhe de implementação. Uma requisição HTTP com tempo limite de 5 segundos executada dentro do laço principal congelaria, por até esse período, a leitura do sensor PIR, o temporizador do relé e a supervisão da conexão Wi-Fi. Com a tarefa dedicada, o laço principal permanece com período da ordem de milissegundos, e o sistema continua respondendo enquanto a imagem é transmitida. Um par de indicadores de estado impede que dois envios se sobreponham: um novo pedido de detecção é recusado enquanto o anterior não terminar, e esse estado é exposto na rota /api/status.

Uma limitação operacional deve ser registrada: o endereço do servidor de reconhecimento é compilado no firmware. Se o endereço IP do computador que hospeda o servidor mudar, é necessário regravar a placa. Analogamente, o endereço do próprio ESP32-CAM é obtido por DHCP e pode mudar quando uma nova concessão é atribuída, o que exige reserva de endereço no roteador para uma instalação estável.

### 3.4.4 Gestão de energia e de conectividade

Este ponto constitui uma mudança deliberada em relação ao projeto originalmente planejado. A concepção inicial previa manter o ESP32 em hibernação profunda (deep sleep), despertando-o pelo sinal do sensor PIR, com o objetivo de maximizar a autonomia da bateria. Essa estratégia foi descartada e não está implementada.

A razão é uma incompatibilidade entre a hibernação e o requisito de vídeo ao vivo sob demanda. Em hibernação profunda, o rádio Wi-Fi é desligado e a associação com o ponto de acesso é perdida; ao despertar, o dispositivo precisa reassociar-se e obter endereço, processo que consome alguns segundos. Um dispositivo nesse regime não pode ser consultado: o usuário que abrisse o aplicativo para ver a câmera encontraria um dispositivo inalcançável, e o botão de destravamento manual não teria a quem se dirigir. Como o aplicativo desenvolvido tem justamente o vídeo ao vivo e o comando remoto entre suas funções centrais, a disponibilidade permanente prevaleceu sobre a economia de energia.

O firmware, portanto, mantém o rádio continuamente ativo, com a economia de energia do Wi-Fi explicitamente desabilitada (WiFi.setSleep(false)) para reduzir a latência de resposta. A gestão de conectividade é feita por supervisão periódica: a cada 10 segundos o firmware verifica o estado da associação e, se houver perda, dispara reconexão. O LED vermelho embutido comunica o estado ao operador — piscante durante a tentativa de conexão inicial, aceso continuamente quando conectado, apagado em caso de falha.

O temporizador do relé é igualmente não bloqueante: o acionamento registra o instante inicial e a duração, e o laço principal verifica a cada iteração se o prazo expirou, desativando a saída. Não há uso de delay() bloqueante no caminho de acionamento do atuador.

A consequência dessa escolha para a autonomia é direta e deve ser assumida com honestidade: com o rádio permanentemente ativo, o consumo médio é substancialmente maior do que seria em regime de hibernação, e a autonomia das duas células 18650 é proporcionalmente menor. A seção 5 aponta o regime híbrido — hibernação com janelas programadas de disponibilidade — como trabalho futuro.

## 3.5 Desenvolvimento do servidor (backend)

O servidor de processamento foi implementado em Python, escolhido pela vasta disponibilidade de bibliotecas de Visão Computacional. A camada web utiliza o framework FastAPI, servido pelo Uvicorn na porta 8000, o que oferece validação automática dos parâmetros de entrada e documentação interativa das rotas — recurso que se mostrou valioso na depuração da integração com o firmware.

### 3.5.1 Recepção de dados e contrato de rotas

Diferentemente do desenho original, em que o servidor seria um assinante passivo de um tópico de mensagens, o servidor deste projeto expõe um contrato REST explícito, consumido por dois clientes distintos: o firmware, que utiliza apenas POST /detect; e o aplicativo Android, que utiliza as rotas de cadastro, consulta e controle. O Quadro 3 apresenta as principais rotas; endpoints de manutenção, como /reload, não são necessariamente consumidos pelo aplicativo.

Quadro 3 – Rotas do servidor de reconhecimento facial (porta 8000)

Método | Rota | Descrição
GET | /health | Estado do servidor: pessoas e amostras conhecidas, disponibilidade do motor facial, limiar em uso, cômodos e módulos ativos
POST | /reload | Recarrega todos os vetores de características a partir das amostras em disco
POST | /detect | Multipart com file (JPEG), source, e opcionalmente rotation, room e room_id. Rota usada pelo ESP32-CAM no evento do PIR
POST | /scan | JSON {esp32_url?, rotation?, room?, room_id?} — o servidor busca /capture no dispositivo e executa o mesmo pipeline
GET | /detections?limit&offset | Histórico paginado, do mais recente para o mais antigo
GET | /media/detections/<arquivo> | Imagem da detecção (arquivo estático)
GET | /categories | Catálogo de vínculos oferecido na tela de cadastro
GET | /people | Lista de pessoas com id, name, category, rooms, room_names, authorized, samples, status, created_at, access_label
POST | /people | Multipart: name, category, rooms (ids separados por vírgula), authorized e até 5 arquivos por requisição; mínimo de 3 é orientação de prontidão, não validação obrigatória da API
PATCH | /people/{id} | Altera nome, categoria, cômodos e autorização
DELETE | /people/{id} | Remove metadados e amostras
GET | /people/{id}/samples/{n} | Devolve a n-ésima amostra em JPEG
POST | /people/{id}/samples | Acrescenta amostras a um cadastro existente
POST | /enroll/from-esp32 | JSON {person_id, esp32_url?, rotation?} — captura no dispositivo e usa como amostra
GET/POST | /rooms | Lista e cria cômodos
PATCH/DELETE | /rooms/{id} | Renomeia e remove um cômodo
POST | /assistant/ask | Pergunta em português; devolve consulta respondida ou proposta de mudança
POST | /assistant/apply | Aplica uma proposta previamente confirmada pelo administrador

Fonte: o autor (2026), a partir do código-fonte em code/face-server/main.py.

A resposta de /detect e /scan informa o status da detecção — que assume os valores recognized, unknown, person_no_face ou no_face —, a lista de rostos encontrados com identidade e distância, o nome do arquivo gravado e um objeto com os metadados completos da detecção, incluindo o cômodo, o veredito de acesso e sua justificativa textual.

A persistência é feita em arquivos no sistema de arquivos local, sem banco de dados relacional: um diretório por pessoa para as amostras faciais, um arquivo JSON por pessoa para os metadados, um arquivo por cômodo e, para cada detecção, a imagem acompanhada de um arquivo de metadados. Essa escolha é adequada à escala doméstica do protótipo e tem a vantagem, sob a ótica da LGPD, de tornar trivialmente inspecionável e removível todo o dado pessoal armazenado.

### 3.5.2 Pipeline de Visão Computacional

O reconhecimento facial utiliza a biblioteca `face_recognition`, construída sobre a Dlib, complementada pelo OpenCV para as operações de decodificação, rotação e redimensionamento. O processamento de um quadro ocorre em cinco etapas:

1. Rotação. O quadro é girado em 0°, 90°, 180° ou 270° conforme configurado, e o resultado é o que segue para todas as etapas seguintes — inclusive para a gravação em disco, de modo que a miniatura exibida no aplicativo também apareça na orientação correta.

2. Redução de escala. Se a largura excede o limite configurado (1024 pixels por padrão), a imagem é reduzida antes da detecção. Os quadros vindos do ESP32-CAM, em 640 × 480, passam intactos; a redução afeta apenas as fotografias de celular usadas no cadastro.

3. Detecção. O detector HOG da Dlib localiza os rostos presentes, devolvendo as caixas delimitadoras.

4. Extração de características. Para cada rosto localizado, a rede residual da Dlib produz um vetor de 128 dimensões.

5. Comparação. Calcula-se a distância euclidiana entre o vetor extraído e cada vetor cadastrado. A identidade atribuída é a de menor distância, desde que esta seja menor ou igual ao limiar de tolerância configurado.

Duas medições relatadas no registro de desenvolvimento orientaram a configuração desse pipeline e são apresentadas aqui por serem, elas próprias, resultado metodológico.

A primeira justifica a redução de escala. O custo do detector HOG cresce proporcionalmente à área da imagem, e o ganho de resolução não se traduz em ganho de detecção. A Tabela 1 reproduz os tempos relatados para a mesma fotografia e máquina. Sem identificação completa da máquina, repetições e logs do ensaio, os valores constituem registro histórico, não um benchmark reproduzido nesta revisão.

Tabela 1 – Tempo de detecção e rostos encontrados em função da largura analisada

Largura analisada | Tempo de detecção | Rostos encontrados
2544 px (original do celular) | 7,49 s | 1
1024 px | 1,65 s | 1
640 px | 1,04 s | 1

Fonte: o autor (2026)

A redução para 1024 pixels corta o tempo em cerca de 78% sem alterar o resultado da detecção, o que fixou esse valor como padrão de configuração.

A segunda medição justifica a escolha do detector. A Dlib oferece também um detector baseado em rede convolucional (cnn), capaz de localizar rostos em ângulos que o HOG não alcança. Medido nesta máquina, sobre uma fotografia, o detector cnn consumiu 166 segundos, contra 1,6 segundo do HOG — uma diferença de duas ordens de magnitude que o coloca muito acima de qualquer tempo limite aceitável para o aplicativo. O detector cnn foi, portanto, descartado, e a limitação decorrente foi transferida para a interface: a tela de cadastro instrui explicitamente o usuário a enviar fotografias com o rosto de frente. A seção 4.4 discute a consequência dessa restrição.

Registre-se ainda uma característica de robustez do servidor: as dependências pesadas de visão computacional são importadas de forma tolerante. Se a Dlib não estiver disponível no ambiente, o servidor ainda inicia, sinalizando o motor como indisponível em /health; as rotas de reconhecimento passam a responder com código 503 e uma mensagem de instalação, enquanto consultas, edição de metadados, gestão de cômodos e histórico permanecem acessíveis. A criação de pessoa por POST /people também exige o motor facial e retorna 503 quando ele está indisponível.

### 3.5.3 Motor de decisão de acesso por cômodo

Esta subseção descreve o componente que substitui o "Motor de Regras" originalmente concebido e materializa a separação de responsabilidades defendida na seção 2.5.

O modelo de autorização assenta-se sobre duas entidades. Um cômodo é um lugar da casa vigiado por uma câmera, cadastrado pelo administrador. Uma pessoa possui um nome, uma categoria de vínculo (Morador, Visitante ou Prestador), a lista de cômodos que pode acessar e uma chave mestra booleana de autorização. A categoria é meramente descritiva: ela documenta o vínculo e organiza a listagem, mas não participa da decisão. Quem decide é a lista de cômodos e a chave mestra.

Cada dispositivo, por sua vez, tem um cômodo associado, informado a cada requisição pelo aplicativo ou, no caminho do PIR, lido da configuração do servidor.

A decisão é a tabela apresentada no Quadro 4, avaliada estritamente nesta ordem.

Quadro 4 – Decisão de acesso

Ordem | Condição avaliada | Resultado
1 | Pessoa com chave mestra de autorização falsa | NEGADO (a chave mestra prevalece sobre tudo)
2 | Cômodo não resolvido após considerar a requisição e a configuração padrão | SEM OPINIÃO — decide apenas a chave mestra
3 | Cômodo consta na lista de cômodos liberados da pessoa | PERMITIDO
4 | Qualquer outro caso | NEGADO (fecha por padrão)

Fonte: o autor (2026), a partir de code/face-server/access_control.py.

Três propriedades desse desenho merecem comentário.

A primeira é a restrição por padrão quando existe um cômodo resolvido: sem esse cômodo na lista da pessoa, o acesso é negado. Há uma exceção relevante: se o cômodo não for informado nem resolvido pelo servidor, evaluate retorna None e a autorização cadastral permanece válida. Isso também pode ocorrer com identificador ou nome inexistente. Portanto, ausência de informação não equivale sempre a negação; a instalação precisa garantir a configuração correta do cômodo.

A segunda é que a decisão por cômodo apenas restringe. Ela pode transformar em negado o acesso de alguém que a chave mestra permitiria, mas jamais autoriza quem a chave mestra bloqueou. As camadas se compõem por conjunção, nunca por disjunção.

A terceira diz respeito à migração de cadastros antigos. Uma versão anterior do sistema organizava permissões em "níveis de acesso" intermediários, aos quais as pessoas eram associadas. Ao ler um cadastro nesse formato, o servidor o converte automaticamente: o nome do nível torna-se a categoria e os cômodos do nível passam para a pessoa. Cadastros ainda mais antigos, que possuíam apenas uma categoria em texto, mantêm a categoria e ficam sem nenhum cômodo — deliberadamente. Migrar um cadastro para um estado mais permissivo do que o original é precisamente o tipo de conversão silenciosa que abre uma porta sem que ninguém tenha decidido abri-la.

Por fim, a frase explicativa exibida no aplicativo ("Morador: Banheiro, Cozinha", "Não permitido em Quarto do João") é gerada por modelo de texto (*template*), não por modelo de linguagem: é instantânea, funciona sem conexão e produz sempre a mesma saída para o mesmo cadastro.

### 3.5.4 Módulos complementares de percepção e de interface

Três módulos adicionais complementam o sistema, todos opcionais e todos com comportamento definido para o caso de estarem desabilitados.

Verificação de vivacidade (*anti-spoofing*). O ataque que este módulo combate é direto: exibir à câmera uma fotografia impressa, ou a tela de um celular, com o rosto de alguém autorizado. Sem verificação adicional, o reconhecimento facial aceita a imagem exatamente como aceitaria a pessoa. Como o firmware envia um único quadro por evento, métodos baseados em movimento — piscar de olhos, microexpressões — não são aplicáveis sem alterar o firmware para enviar vídeo. Optou-se por uma abordagem de quadro único, na linha da análise de textura e frequência, extraindo do recorte do rosto pistas como nitidez (variância do laplaciano), energia de alta frequência e pico de moiré na transformada de Fourier, entropia e desvio do padrão binário local, saturação de cor e reflexo especular. Um discriminante linear ajustado sobre amostras reais e falsas separa as duas classes. O módulo vem desabilitado por padrão e não emite opinião sem um modelo calibrado com amostras capturadas pelo próprio ESP32-CAM — comportamento de falha aberta: a ausência de resultado não bloqueia a autorização. Trata-se de uma limitação de segurança, e não de uma garantia contra apresentação de fotografias.

Detecção de presença. O detector HOG é exigente: requer rosto frontal, nítido e razoavelmente grande. Quando ele não encontra nada, o evento era registrado como "quadro vazio", mesmo havendo uma pessoa visível de lado, de costas ou mal iluminada — apagando do registro de segurança justamente o evento mais interessante, o de alguém que passou sem ser identificado. Este módulo executa, apenas quando o reconhecimento falhou, um segundo conjunto de detectores mais tolerantes: cascata de Haar frontal, cascata de perfil (aplicada nos dois sentidos, com espelhamento) e detector HOG de pessoas de corpo inteiro. Todos acompanham a instalação padrão do OpenCV, sem download adicional e sem que qualquer dado saia da máquina. O resultado é um quarto estado de detecção, person_no_face, exibido no aplicativo como "Rosto não visível". Por rodar apenas no caminho de falha, o módulo não onera a detecção bem-sucedida.

Assistente do administrador. Um modelo de linguagem executado localmente traduz perguntas em português em consultas ao histórico ("quem entrou na cozinha ontem à noite?") ou em propostas de mudança de configuração ("libere o Antônio na garagem"). O modelo escolhe apenas a intenção e os parâmetros; a execução é código convencional, e toda operação de escrita retorna como proposta, aplicada somente após confirmação explícita do administrador na tela. A confirmação é uma etapa da interface do aplicativo. A API /assistant/apply recebe a proposta diretamente e não verifica uma sessão autenticada nem um comprovante de confirmação anterior; portanto, a etapa de interface não constitui uma barreira de autorização do servidor. O módulo fica desabilitado se nenhum modelo for configurado, e o restante do sistema opera igual.

## 3.6 Aplicativo Android

O aplicativo foi desenvolvido em Kotlin, com interface declarativa em Jetpack Compose, comunicação HTTP por Retrofit sobre OkHttp e serialização por kotlinx.serialization. A navegação organiza-se em três abas — Principal, Dispositivos e Pessoas —, com telas de detalhe sobrepostas para o cadastro de pessoa e para o gerenciamento de cômodos.

A arquitetura do aplicativo organiza as telas em ViewModels, repositórios e modelos de domínio, com StateFlow e corrotinas para atualização da interface. O Preferences DataStore persiste dispositivos, seleção e endereço do servidor. O histórico é consultado periodicamente a cada 5 segundos e o estado dos dispositivos a cada 8 segundos, sem push de detecções. A configuração Android declara minSdk 26, targetSdk 37 e compileSdk 37.

Como cada instalação tem endereços próprios, todas as rotas são declaradas com URL absoluta, informada em tempo de execução a partir do cadastro do dispositivo e do endereço do servidor, ambos persistidos localmente.

Um aspecto do cliente HTTP merece registro por ter origem em um defeito observado em campo. O aplicativo mantém três perfis de tempo limite distintos: 8 segundos para consultas curtas (estado do dispositivo, lista de pessoas, histórico), de modo que um dispositivo desligado apareça como indisponível rapidamente; 90 segundos para as rotas que executam visão computacional; e leitura sem limite para o streaming MJPEG e o download de imagens, já que o fluxo de vídeo é uma resposta que nunca termina. O perfil intermediário resolve uma falha concreta: com o limite curto aplicado ao cadastro, o servidor respondia com sucesso enquanto o aplicativo já havia desistido — a pessoa era efetivamente criada, mas a tela acusava erro, levando o usuário a cadastrá-la novamente.

As telas principais são descritas a seguir e ilustradas na seção 4.2.

Principal. Exibe o seletor de dispositivo, o vídeo ao vivo com indicador "Ao vivo" e a identificação do endereço, o botão Escanear ambiente e o carrossel Rostos detectados recentes, no qual cada detecção aparece como miniatura com moldura colorida segundo o veredito, o nome ou rótulo correspondente e o carimbo de data e hora.

Dispositivos. Permite cadastrar, editar e remover câmeras, informando nome, endereço IP, porta de API e porta de stream. O aplicativo verifica a conectividade antes de gravar. Dois parâmetros adicionais são configurados aqui: o cômodo vigiado por aquela câmera, enviado ao servidor a cada verificação, e a orientação da imagem, em incrementos de 90°. A tela também oferece os comandos de iluminação e de liberação manual de acesso, este com confirmação.

Pessoas. Lista os cadastros com miniatura da primeira amostra, categoria, cômodos liberados e uma etiqueta de prontidão — "Ativo" ou "Pendente" —, acompanhada, quando pendente, da indicação de quantas amostras ainda faltam. Um menu por item permite editar o cadastro, alterar a chave mestra de autorização ou remover a pessoa. Dá acesso, ainda, à tela de gerenciamento de cômodos e ao assistente.

Cadastrar/Editar Pessoa. Reúne a grade de 3 a 5 amostras faciais — obtidas da galeria ou capturadas diretamente pelo ESP32-CAM —, o nome completo, a categoria de vínculo e a lista de cômodos com caixas de seleção. Quando o servidor recusa alguma fotografia, a tela permanece aberta, marca na grade a imagem recusada, apresenta o motivo e passa a editar a pessoa já criada, de modo que salvar novamente não gere cadastro duplicado.

## 3.7 Procedimento de testes

A validação seguiu três frentes complementares.

Testes automatizados. O repositório contém testes do servidor para acesso, cadastros, detecção, presença, vivacidade e assistente, além de testes unitários e instrumentados do aplicativo para mapeamento de dados, processamento MJPEG e navegação. Dublês de componentes permitem verificar parte da lógica sem executar o reconhecimento facial real. A verificação por dublês não mede a acurácia biométrica nem substitui ensaios de integração com hardware real.

Ensaios de configuração. Foram conduzidos experimentos dirigidos para fixar parâmetros: a varredura de limiar de reconhecimento (seção 4.4), a medição de tempo de detecção por resolução (Tabela 1) e a verificação do efeito da rotação sobre a detecção (seção 4.6).

Testes práticos em ambiente real. Com o sistema completo em operação — dispositivo alimentado por bateria, servidor em execução no computador da rede local e aplicativo instalado no aparelho celular —, foram encenadas as quatro situações que o sistema precisa distinguir, com pessoas reais diante da câmera. Os resultados são apresentados na seção 4.3. A captura foi disparada pelo botão Escanear ambiente, para controlar o instante do registro; o caminho automático pelo sensor PIR foi verificado separadamente, pelo incremento do contador de disparos exposto em /api/status e pelo aparecimento das detecções correspondentes no histórico.

# 4 RESULTADOS E DISCUSSÃO

Esta seção apresenta os resultados obtidos. Inicia pelo protótipo construído (4.1) e pelas telas do aplicativo (4.2); expõe em seguida os testes práticos de classificação de acesso (4.3), que constituem a evidência principal de funcionamento; e prossegue com as medições de acurácia biométrica (4.4), tempo de resposta do cadastro (4.5), efeito da orientação da câmera (4.6) e consumo de recursos do firmware (4.7). Encerra com a discussão das limitações (4.8).

## 4.1 O protótipo construído

O sistema foi levado à condição de funcionamento integral de ponta a ponta, com as três camadas operando simultaneamente sobre hardware real. O protótipo físico é o mostrado nas Figuras 7 e 8 da seção 3.2.4: ESP32-CAM em protoboard, sensor PIR elevado em haste para ampliação do campo de visão, alimentação autônoma por duas células 18650 reguladas pelo LM2596.

A integração das três camadas revelou uma classe de defeitos que nenhum teste isolado de componente havia capturado — todos relativos à fronteira entre subsistemas, e todos corrigidos: conflito de atribuição de pino entre o sensor e a UART de depuração (seção 3.2.2); conflito entre o relé e um strapping pin do microcontrolador, que impedia a inicialização da placa (seção 3.2.4); divergência entre o endereço IP configurado e o endereço real do servidor, cuja mensagem de erro no aplicativo não indicava qual endereço havia falhado — o que motivou a exibição do endereço e a verificação de disponibilidade antes de gravar o cadastro; tempo limite curto abortando o cadastro no cliente enquanto o servidor concluía a operação (seção 3.6); e a orientação física da câmera invalidando toda detecção (seção 4.6).

O registro dessa classe de problemas é, em si, um resultado da pesquisa: em sistemas IoT compostos por firmware, servidor e aplicação móvel desenvolvidos separadamente, os defeitos de maior impacto concentram-se nas interfaces, e sua identificação exige teste integrado com hardware real, não sendo substituível por testes unitários.

## 4.2 Telas do aplicativo desenvolvido

O aplicativo Android materializa a camada de aplicação. As Figuras 9 a 12 apresentam suas telas de configuração e cadastro.

A Figura 9 exibe a tela Cadastrar Pessoa, com a grade de amostras faciais, a orientação explícita quanto à necessidade de fotografias frontais, a opção de captura direta pelo ESP32-CAM, o campo de nome, os vínculos disponíveis e a lista de cômodos com caixas de seleção.

Figura 9 – Tela de cadastro de pessoa no aplicativo Android

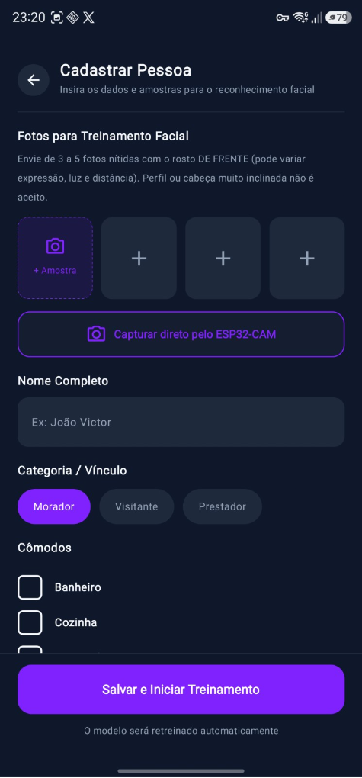
[picture p12: figure]

Fonte: o autor (2026).

A Figura 10 apresenta a tela Pessoas, com os cadastros existentes. Observa-se a etiqueta de prontidão "Pendente" acompanhada da explicação do que falta — "faltam 2 amostras", "falta 1 amostra" —, comportamento adotado após se constatar que uma etiqueta sem justificativa não informava ao usuário qual ação tomar. Cada item exibe também a categoria e a relação de cômodos liberados.

Figura 10 – Tela de pessoas cadastradas

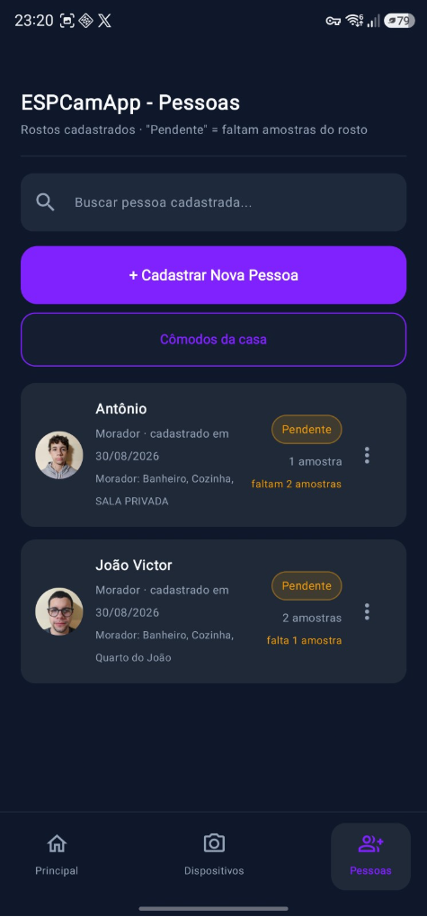
[picture p13: figure]

Fonte: o autor (2026).

A Figura 11 mostra a tela Cômodos da casa, na qual o administrador cadastra, renomeia e remove os lugares que o controle de acesso reconhece. Um cômodo removido sai automaticamente da ficha de todas as pessoas que o tinham marcado. Na parte inferior aparece o campo do assistente, onde menciona de que ele nunca libera acesso sozinho e de que toda mudança passa por confirmação.

Figura 11 – Tela de cadastro dos cômodos da casa

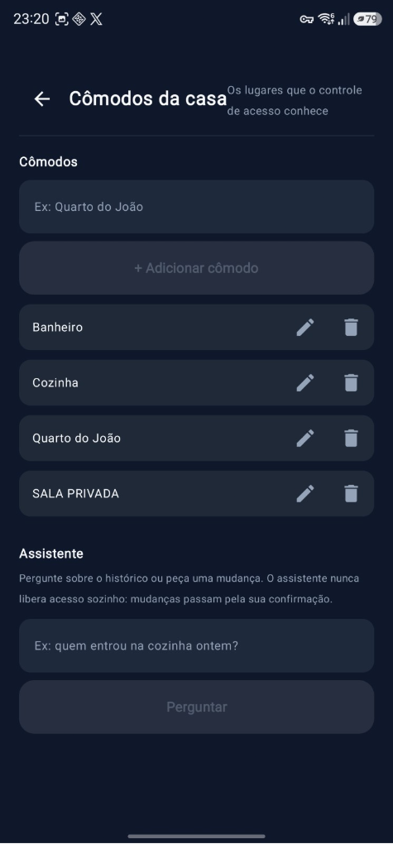
[picture p14: figure]

Fonte: o autor (2026).

A Figura 12 apresenta o diálogo Editar dispositivo, com o nome, o endereço IP, a porta de API (80) e a porta de stream (81), além dos dois parâmetros que ligam o dispositivo à lógica do servidor: o cômodo vigiado — no exemplo, "Quarto do João" — e a orientação da imagem, ajustada em 180° por a câmera estar montada invertida.

Figura 12 – Tela de configuração e edição do dispositivo

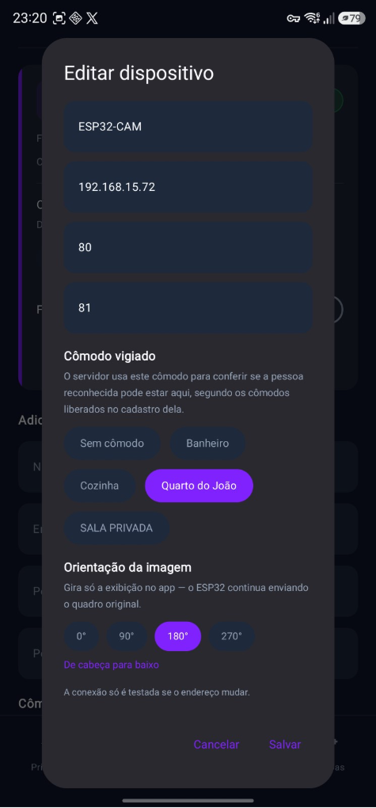
[picture p15: figure]

Fonte: o autor (2026).

## 4.3 Testes práticos de classificação de acesso

Esta subseção constitui a evidência central de funcionamento do sistema. Foram encenadas, com pessoas reais diante da câmera do protótipo, as quatro situações que o sistema precisa distinguir. Em todos os casos o dispositivo estava configurado para vigiar o cômodo "Quarto do João", e as capturas foram disparadas pelo botão Escanear ambiente.

### 4.3.1 Caso 1 — Pessoa reconhecida e autorizada no cômodo

A Figura 13 mostra o resultado quando a pessoa diante da câmera está cadastrada, com a chave mestra ativa, e o cômodo vigiado consta de sua lista de cômodos liberados. O sistema reconhece a identidade, aplica a regra 3 do Quadro 4 e emite o veredito Autorizado, exibido em moldura verde com o nome da pessoa e o carimbo de data e hora.

Figura 13 – Teste prático — pessoa reconhecida e autorizada no cômodo vigiado

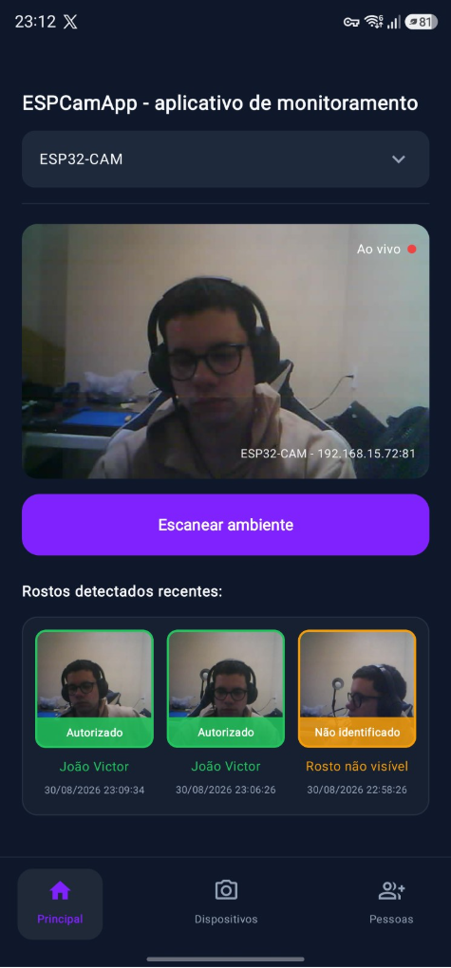
[picture p16: figure]

Fonte: o autor (2026).

Observa-se, no mesmo carrossel, que a terceira detecção — anterior no tempo — foi classificada como "Rosto não visível", em moldura laranja. Trata-se do estado person_no_face descrito na seção 3.5.4: houve alguém no quadro, mas o rosto não pôde ser identificado. O contraste entre as três miniaturas evidencia que o sistema distingue reconhecimento bem-sucedido de presença sem identificação, em vez de tratar ambos como ausência.

### 4.3.2 Caso 2 — Pessoa reconhecida, porém não autorizada naquele cômodo

Este é o caso que valida especificamente a decisão por cômodo, e o que mais claramente diferencia o sistema de um reconhecedor facial simples. A Figura 14 mostra o resultado quando a pessoa diante da câmera está corretamente cadastrada e é corretamente identificada pelo nome, mas o cômodo vigiado não consta de sua lista de cômodos liberados.

Figura 14 – Teste prático — pessoa reconhecida, porém não autorizada no cômodo

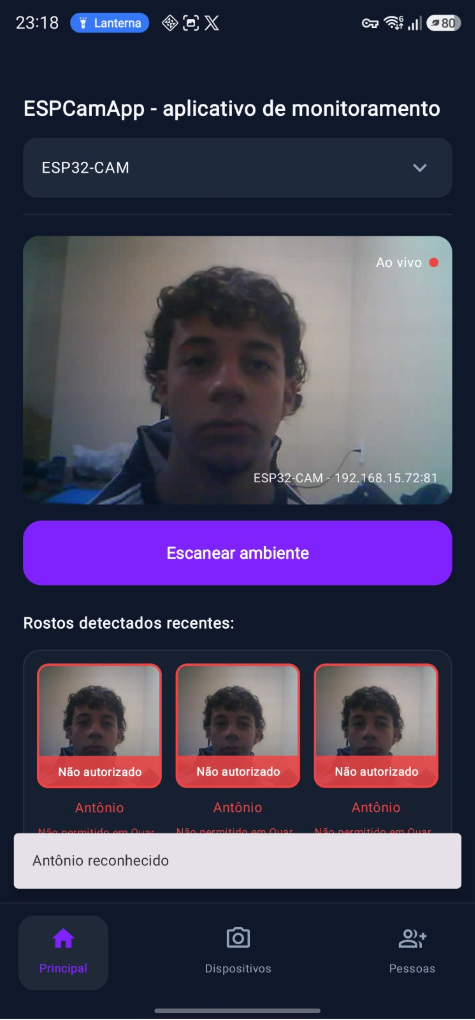
[picture p17: figure]

Fonte: o autor (2026).

O sistema exibe simultaneamente três informações distintas: a identidade reconhecida — a mensagem de retorno confirma "Antônio reconhecido" —, o veredito Não autorizado, em moldura vermelha, e a justificativa "Não permitido em Quarto do João". A regra 4 do Quadro 4 foi aplicada: a pessoa é conhecida e sua chave mestra está ativa, mas o cômodo não consta de seu cadastro, e o sistema fecha por padrão.

A relevância desse resultado está em separar identidade de autorização. Um sistema que se limitasse a comparar rostos concluiria "pessoa conhecida" e liberaria o acesso. O sistema desenvolvido reconhece a pessoa, comunica ao operador quem ela é — informação útil para o registro de segurança — e ainda assim nega o acesso, com a justificativa explícita da negativa.

### 4.3.3 Caso 3 — Rosto detectado sem cadastro correspondente

A Figura 15 mostra o comportamento diante de uma pessoa cujo rosto é detectado com nitidez, mas cujo vetor de características não corresponde a nenhuma amostra cadastrada dentro do limiar de tolerância. O estado registrado é unknown, exibido em moldura vermelha com o rótulo Sem cadastro e o nome de exibição "Desconhecido"; a mensagem de retorno informa "Rosto detectado, mas sem cadastro".

Figura 15 – Teste prático — rosto detectado sem cadastro correspondente

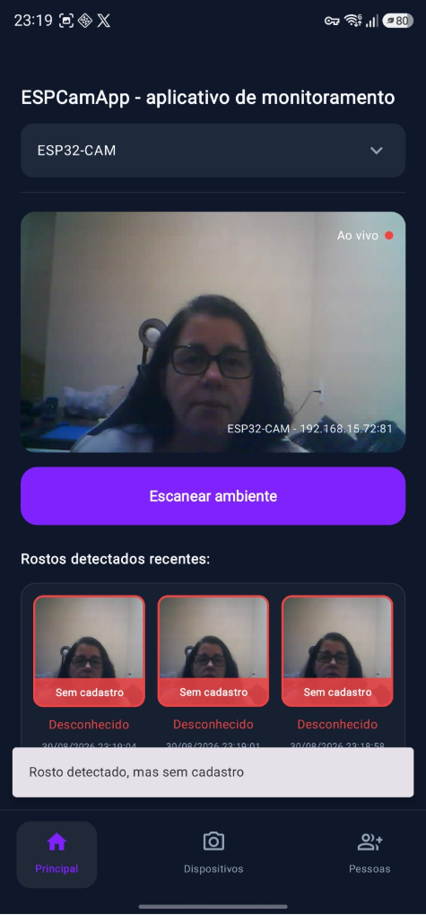
[picture p18: figure]

Fonte: o autor (2026).

Este é o caso de maior interesse para a vigilância: alguém esteve no ambiente monitorado e não pertence ao conjunto de pessoas conhecidas. A imagem é gravada com data e hora e permanece disponível no histórico, cumprindo a função probatória que a seção 2.4 associa ao dever de rastreabilidade.

### 4.3.4 Caso 4 — Presença detectada sem rosto identificável

A Figura 16 mostra o quarto estado, introduzido pelo módulo de detecção de presença descrito na seção 3.5.4. A pessoa está no quadro com o rosto parcialmente ocluído — boné e mão à frente do rosto —, condição em que o detector HOG não localiza face alguma. Em vez de registrar "quadro vazio", os detectores auxiliares confirmam que há alguém, e o sistema emite o estado person_no_face, exibido em moldura laranja com o rótulo Não identificado e a mensagem "Há alguém no quadro, mas o rosto não pôde ser identificado".

Figura 16 – Teste prático — presença detectada sem rosto identificável

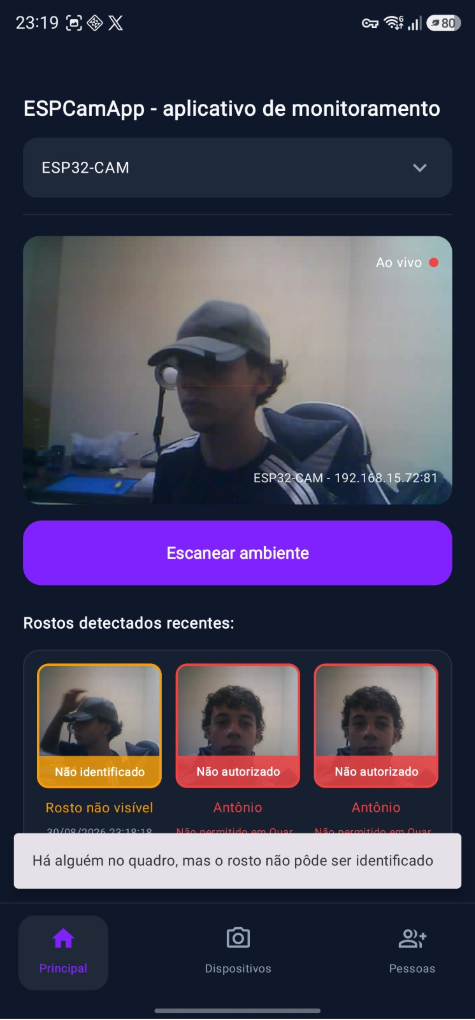
[picture p19: figure]

Fonte: o autor (2026).

A distinção é relevante sob a ótica da segurança. Uma pessoa que se aproxima de uma câmera com o rosto deliberadamente encoberto é, do ponto de vista da vigilância, um evento mais significativo do que um rosto desconhecido, e não menos. Tratar essa situação como ausência apagaria do registro justamente a tentativa de evasão. Note-se também que o rótulo escolhido é "Não identificado", e não "Não autorizado": não havendo identidade estabelecida, não há a quem atribuir uma negativa de acesso.

### 4.3.5 Síntese dos testes práticos

O Quadro 5 consolida os quatro casos e o comportamento observado.

Quadro 5 – Síntese dos testes práticos de classificação de acesso

Caso | Situação encenada | Estado registrado | Veredito exibido | Moldura | Figura
1 | Pessoa cadastrada, autorizada, no cômodo liberado | recognized | Autorizado, com o nome | Verde | 13
2 | Pessoa cadastrada e reconhecida, cômodo não liberado | recognized | Não autorizado, com o nome e a justificativa | Vermelha | 14
3 | Rosto nítido sem cadastro correspondente | unknown | Sem cadastro / Desconhecido | Vermelha | 15
4 | Pessoa presente, rosto não identificável | person_no_face | Não identificado / Rosto não visível | Laranja | 16

Fonte: o autor (2026).

Os quatro estados foram corretamente discriminados em ambiente real, com o veredito e a justificativa apresentados ao operador em cada caso. Cumpre-se, portanto, o objetivo geral enunciado na seção 1: classificação automática dos acessos, com resposta disponibilizada em tempo real ao responsável.

Os casos são demonstrações qualitativas, sem número planejado de repetições e sem amostra suficiente para estimar taxa de acerto operacional.

## 4.4 Desempenho do reconhecimento: varredura de limiar (FAR × FRR)

Foi conduzido um experimento dirigido de varredura do limiar de tolerância, sobre as amostras efetivamente cadastradas no sistema, com o objetivo de verificar se o valor padrão da biblioteca é adequado a este ambiente. O conjunto histórico desse experimento é o descrito no Quadro 6. Na inspeção de 8 de setembro de 2026, os arquivos locais contêm dois cadastros e três amostras; portanto, esse conjunto histórico não coincide com o estado atual. O CSV da varredura permanece disponível.

Quadro 6 – Conjunto de amostras utilizado na varredura de limiar

Pessoa | Amostras cadastradas
Antônio | 1
Lincoln | 1
João Victor | 2

Fonte: o autor (2026).

Desse conjunto derivam 1 par genuíno (duas amostras da mesma pessoa) e 5 pares impostores (amostras de pessoas distintas). A Tabela 2 apresenta a curva obtida.

Tabela 2 – Taxas de falsa aceitação e falsa rejeição em função do limiar

Limiar | FAR | FRR
0,30 – 0,34 | 0,000 | 1,000
0,36 – 0,50 | 0,000 | 0,000
0,52 – 0,58 | 0,200 | 0,000
0,60 (padrão da configuração) | 0,400 | 0,000
0,62 – 0,70 | 0,400 | 0,000

Fonte: o autor (2026).

O achado principal é desfavorável à configuração então vigente. Com o limiar de 0,60 — valor padrão da biblioteca e da configuração do projeto —, 2 dos 5 pares impostores são aceitos como sendo a mesma pessoa. As distâncias medidas entre pares de pessoas distintas foram de 0,506 e 0,582 no par Antônio × João Victor, ambas abaixo do limiar; os demais pares ficaram entre 0,728 e 0,760, com folga confortável.

A consequência operacional é concreta e deve ser enunciada sem atenuação: o sistema, com o limiar de 0,60, pode reconhecer Antônio como sendo João Victor. Como João Victor é a pessoa com maior número de cômodos liberados, essa falsa aceitação poderia liberar o acesso à pessoa errada se a liberação automática estivesse habilitada e as demais verificações não o impedissem — exatamente o modo de falha que a seção 2.3.2 identifica como o mais grave em um sistema de segurança.

A Tabela 3 apresenta as distâncias de 62 arquivos JSON locais classificados como recognized, recontados em 8 de setembro de 2026. A seleção considera todos os arquivos com esse status e distância numérica, sem executar novo reconhecimento nem atribuir verdade de referência às imagens.

Tabela 3 – Distâncias observadas em 62 detecções classificadas como reconhecidas

Estatística | Valor
Distância mínima | 0,337
Distância média | 0,453
Distância máxima | 0,598

Fonte: o autor (2026), a partir dos arquivos locais de detecção, consultados em 8 out. 2026.

Essas 62 observações não possuem verdade de referência registrada que permita verificar a identidade real de cada captura. A distância é uma medida de similaridade, e não uma probabilidade de acerto. Portanto, o histórico descreve o comportamento do algoritmo e não permite calcular sua acurácia nem concluir, apenas pela proximidade entre valores, que houve troca de identidade em uma detecção específica.

Duas recomendações decorrem do experimento e ficam registradas:

1. Avaliar limiares mais restritivos em um conjunto independente. O valor 0,45 pertence à faixa sem erro observada nesse conjunto pequeno, mas não foi validado como valor operacional. A escolha deve considerar novas capturas, identidades distintas e as consequências de falsas aceitações e rejeições.

2. Ampliar e diversificar as amostras e separar cadastro de avaliação. Três amostras definem a etiqueta de prontidão, mas uma pessoa pendente já pode participar do reconhecimento. Adicionar imagens não garante separar as distribuições genuína e impostora; a comparação por menor distância pode também aumentar oportunidades de correspondência incorreta. É necessário medir o efeito no conjunto independente.

Um par genuíno e cinco pares impostores permitem somente uma varredura exploratória das distâncias. Não sustentam estimativa generalizável de curva ROC ou EER. A avaliação futura deve ampliar o conjunto e separar as imagens de cadastro das imagens de teste.

## 4.5 Tempo de resposta das operações de cadastro

O cadastro, a edição e a exclusão de pessoas apresentavam originalmente tempos de resposta da ordem de dezenas de segundos. A investigação identificou duas causas independentes, ambas medidas.

A primeira era o reprocessamento integral do banco: as rotas de cadastro, de acréscimo de amostras, de captura direta e de exclusão chamavam a rotina de recarga completa, que recodifica todas as amostras de todas as pessoas. O custo crescia com o tamanho do banco inteiro a cada operação individual. A correção foi implementar indexação incremental — a rotina passa a codificar somente a amostra nova — e remoção seletiva — a exclusão retira do índice apenas a pessoa removida.

A segunda era o processamento de fotografias em tamanho original, cujo efeito está quantificado na Tabela 1 da seção 3.5.2. A correção foi a redução de escala prévia à detecção.

A Tabela 4 reproduz os tempos relatados no desenvolvimento com três amostras de 2544 pixels. As alterações de indexação e timeout estão presentes no código, mas os tempos não foram reproduzidos e não estão acompanhados de logs completos e repetições.

Tabela 4 – Tempo das operações de cadastro antes e depois das correções

Operação | Antes | Depois
Cadastro de pessoa (3 amostras) | 22,3 s | 5,9 s
Exclusão de pessoa | crescia com o tamanho do banco | ~0,2 s
Edição de cadastro | — | ~0,2 s

Fonte: o autor (2026).

O reconhecimento no caminho normal de operação não foi afetado, uma vez que os quadros de 640 × 480 enviados pelo ESP32-CAM já estavam abaixo do limite de redução.

## 4.6 Efeito da orientação da câmera sobre a detecção

Este resultado tem valor prático desproporcional à sua simplicidade e merece registro explícito, por ser um modo de falha silencioso.

Durante a integração, todas as verificações retornavam "nenhum rosto encontrado", mesmo com pessoas cadastradas posicionadas diante da câmera. A causa foi identificada como a montagem física: a câmera estava instalada de cabeça para baixo, e o detector HOG da Dlib não localiza rostos invertidos. A Tabela 5 apresenta a medição realizada sobre o mesmo quadro.

Tabela 5 – Rostos detectados em função da rotação aplicada ao quadro

Imagem analisada | Rostos encontrados
Original, como sai da câmera (invertida) | 0
Girada 180° antes da detecção | 1

Fonte: o autor (2026).

A solução adotada foi introduzir a rotação como parâmetro do pipeline, aplicada antes da detecção, conforme descrito na seção 3.5.2. A imagem é gravada já rotacionada, de modo que a miniatura exibida no aplicativo também apareça na orientação correta. O valor é configurável por dispositivo no aplicativo e possui um padrão no servidor, este último usado no caminho do sensor PIR, em que o firmware não informa orientação.

A relevância deste achado está em seu caráter de falha silenciosa. O sistema não emitia erro algum: reportava, com correção formal, que não havia rostos no quadro. Sem a inspeção da imagem gravada, a causa é praticamente indistinguível de uma falha do modelo de reconhecimento. Fica a recomendação de projeto: em sistemas de visão computacional embarcada, a orientação física da instalação deve ser tratada como parâmetro explícito de configuração, e não presumida.

## 4.7 Consumo de recursos do firmware

O registro de desenvolvimento informa a ocupação da Tabela 6 para uma compilação destinada à placa esp32:esp32:esp32cam. Sem um log que identifique a versão compilada e as ferramentas, esses percentuais não caracterizam uma compilação reproduzida da versão atual.

Tabela 6 – Ocupação de memória do firmware compilado

Recurso | Ocupação
Memória flash (programa) | 35%
Memória RAM | 22%

Fonte: o autor (2026).

Os percentuais de compilação não permitem concluir que há margem suficiente em execução. A RAM estática informada pelo compilador não inclui todo o uso dinâmico de heap, pilhas, bibliotecas de rede e buffers; a PSRAM exige avaliação separada. O próprio firmware expõe free_heap e free_psram em /api/status, permitindo instrumentação posterior sob carga.

Não foram medidos o consumo de corrente nem a autonomia por baterias. Esses parâmetros exigem instrumentação nos estados de repouso, captura, transmissão e vídeo ativo.

## 4.8 Limitações e ameaças à validade

Autorização e atuação. O servidor seleciona o rosto reconhecido de menor distância para a decisão principal. Outros rostos na mesma imagem não formam uma política de autorização coletiva. Sem cômodo resolvido, a autorização cadastral pode prevalecer; o destravamento automático vem desabilitado por padrão. Não foi comprovado acionamento físico de uma fechadura pelos registros consultados.

Proteção administrativa e registro. O servidor não autentica suas rotas de cadastro, imagens ou aplicação de propostas. A confirmação de interface não protege chamadas diretas. O comando de destravamento antecede a persistência da detecção; uma falha de gravação pode ocorrer depois da atuação. Assim, a persistência do registro de toda abertura não está garantida.

Armazenamento e múltiplas câmeras. Não há gravação no cartão SD de 2 GB nem política automática de retenção dos arquivos de detecção. O aplicativo cadastra múltiplos dispositivos, mas o evento PIR não transmite um identificador de dispositivo nem sua URL; o servidor depende da configuração padrão de cômodo e de destino do destravamento. A associação correta em múltiplas câmeras ainda exige evolução e validação.

Esta subseção reúne, de forma consolidada, as limitações do trabalho, por entendimento de que sua omissão comprometeria o valor dos resultados apresentados.

Acurácia biométrica. Conforme a seção 4.4, o conjunto de avaliação é pequeno demais para estimar FAR e FRR operacionais; a varredura histórica apresentou correspondências impostoras sob o limiar padrão 0,60.

Restrição de pose no cadastro. O detector adotado exige rosto aproximadamente frontal. Medição realizada com cinco fotografias da mesma pessoa registrou que as duas frontais foram aceitas — inclusive uma com o rosto três quartos virado — e as três com ângulo acentuado foram recusadas, em qualquer resolução e em qualquer rotação aplicada. A orientação ao usuário é, portanto, variar expressão, iluminação e distância, e não o ângulo da cabeça. O detector convolucional foi excessivamente lento na máquina e no ensaio relatados, conforme a seção 3.5.2.

Ausência de medições de latência e de consumo. Assinaladas nas seções 2.1.3 e 4.7.

Vivacidade não calibrada. O módulo anti-spoofing está implementado, porém desabilitado por padrão por falta de um conjunto de calibração capturado com o próprio ESP32-CAM. Enquanto assim permanecer, o sistema é vulnerável à apresentação de uma fotografia à câmera. Esta é a limitação de segurança mais relevante do protótipo e deve ser declarada em qualquer uso real.

Transporte sem cifragem. Todo o tráfego é HTTP puro na rede local, conforme discutido na seção 2.4.

Um único cliente de vídeo. O ESP32-CAM atende um cliente de stream por vez, limitando o monitoramento simultâneo por mais de um usuário.

Endereçamento estático em código. O endereço do servidor é compilado no firmware, e o endereço do dispositivo é obtido por DHCP, exigindo reserva no roteador para instalação estável (seção 3.4.3).

Escala do experimento. O sistema foi validado com três pessoas cadastradas, um dispositivo e quatro cômodos, em uma residência. O comportamento com dezenas de pessoas e múltiplas câmeras não foi verificado.

# 5 CONSIDERAÇÕES FINAIS

Este trabalho apresentou o desenvolvimento e a análise de um sistema automatizado de controle de acesso que integra Internet das Coisas e Inteligência Artificial, composto por um dispositivo embarcado ESP32-CAM com sensor de presença e alimentação autônoma, um servidor local de reconhecimento facial em Python e um aplicativo Android de monitoramento e gestão, comunicando-se integralmente por HTTP sobre a rede local.

Os registros de demonstração indicam funcionamento integrado do monitoramento e da classificação em ambiente residencial. Os casos ilustram quatro situações de interesse, com resultado e justificativa exibidos ao operador. Não foram estabelecidas taxas de acerto em campo, escalabilidade ou viabilidade econômica comparativa. A ausência de custo total e de ensaios repetidos limita a conclusão à demonstração funcional do protótipo.

Três conclusões de natureza mais geral emergem do desenvolvimento.

A primeira diz respeito à arquitetura de comunicação. A escolha do HTTP, em substituição ao protocolo publica-assina originalmente previsto, mostrou-se acertada para o padrão de tráfego desta aplicação. O sistema não transmite telemetria contínua, mas quadros isolados por evento e um fluxo de vídeo longo — regime em que o peso relativo do cabeçalho tende a ser menor diante do payload, sem medição quantitativa neste trabalho, e no qual as vantagens do modelo requisição-resposta predominam: transporte nativo de imagens, vídeo diretamente do dispositivo ao aplicativo sem intermediário, contrato inspecionável e ausência de um broker como componente adicional de falha. A generalização apropriada não é que um protocolo seja superior ao outro, mas que a escolha deve derivar do padrão de tráfego real da aplicação, e não de uma comparação abstrata de eficiência.

A segunda, e mais importante, diz respeito ao papel da Inteligência Artificial em decisões de consequência física. A tentativa de derivar a regra de acesso por meio de um modelo de linguagem foi abandonada após produzir, para uma observação de cadastro restritiva, uma interpretação que liberaria a pessoa na residência inteira. A separação adotada — a IA percebe e conversa, mas não autoriza — não representa desconfiança na tecnologia, e sim reconhecimento de que reconhecimento de padrões e aplicação de regras são problemas de naturezas distintas. Reconhecer um rosto é inerentemente estatístico, e seu erro é mensurável por FAR e FRR. Decidir se alguém pode entrar em um cômodo é a avaliação de uma regra que deve ser determinística, auditável por um ser humano e falhar no sentido restritivo. Colocar um componente probabilístico nesse segundo papel introduz um modo de falha — permissivo, plausível e silencioso — que a separação adotada procura reduzir. Permanecem, entretanto, falsas aceitações biométricas, a exceção de cômodo não resolvido e interfaces administrativas sem autenticação.

A terceira diz respeito à natureza dos defeitos em sistemas IoT integrados. Os problemas de maior impacto encontrados neste desenvolvimento não estavam nos algoritmos, mas nas fronteiras entre subsistemas: um pino de sensor coincidindo com a UART de depuração, um atuador ligado a um pino de configuração de boot, um endereço de servidor divergente, um tempo limite de cliente menor que o tempo de processamento do servidor e, sobretudo, uma câmera montada de cabeça para baixo, cujo efeito era o sistema reportar corretamente que não havia rostos onde havia pessoas. A avaliação integrada com hardware real é necessária para esses comportamentos, embora testes de configuração e de contratos também possam antecipar parte dos defeitos. Trata-se de constatação a ser considerada no planejamento de projetos semelhantes.

Como contrapartida honesta, registram-se as limitações que impedem a recomendação do protótipo para uso em produção no estado atual. A varredura de limiar demonstrou que a configuração vigente admite falsas aceitações entre duas das pessoas cadastradas, com risco de abertura para a pessoa errada quando a atuação automática estiver habilitada; o conjunto de avaliação é pequeno demais para sustentar afirmações estatísticas; a verificação de vivacidade permanece desabilitada por falta de calibração, deixando o sistema vulnerável à apresentação de uma fotografia; e o transporte não é cifrado. Essas limitações não invalidam a demonstração de viabilidade, mas delimitam com precisão o que foi e o que não foi demonstrado.

Para trabalhos futuros, sugerem-se as seguintes linhas, em ordem aproximada de prioridade:

1. Refazer a avaliação biométrica sobre um conjunto de referência público ou com um número substancialmente maior de voluntários, e fixar o limiar com base nessa medição, em vez do valor padrão da biblioteca.

2. Calibrar e habilitar a verificação de vivacidade, com amostras reais e falsas capturadas pelo próprio ESP32-CAM, e avaliar sua capacidade de reduzir ataques de apresentação em condições representativas, sem presumir eliminação do risco.

3. Instrumentar e medir latência fim a fim e consumo de energia, fechando as duas lacunas quantitativas assinaladas ao longo deste artigo.

4. Investigar um regime híbrido de energia, que combine hibernação profunda com janelas programadas de disponibilidade, recuperando parte da autonomia sacrificada em favor do vídeo sob demanda (seção 3.4.4).

5. Adotar transporte cifrado ou segregação de rede, viabilizando implantação fora de um ambiente estritamente controlado.

6. Validar a operação simultânea de múltiplos dispositivos e clientes de vídeo, possivelmente com um intermediário de redistribuição do fluxo, superando o limite de um cliente por câmera.

7. Desenvolver encapsulamento definitivo do protótipo, com fixação mecânica e proteção contra poeira e umidade.

8. Elaborar o Relatório de Impacto à Proteção de Dados Pessoais (RIPD) e os instrumentos de consentimento, quando exigidos ou adequados ao contexto, documentando a base legal, a finalidade, as medidas de proteção e o uso das imagens (seção 2.4).

# Referências

AMIRKHANOV, Bauyrzhan et al. Evaluating HTTP, MQTT over TCP and MQTT over WEBSOCKET for digital twin applications: A comparative analysis on latency, stability, and integration. International Journal of Innovative Research and Scientific Studies, v. 8, n. 1, p. 679-694, 2025. Disponível em: https://www.ijirss.com/index.php/ijirss/article/view/4414. Acesso em: 26 jan. 2026.

ATZORI, L.; IERA, A.; MORABITO, G. The Internet of Things: A survey. Computer Networks, v. 54, n. 15, p. 2787–2805, 2010.

BRASIL. Lei nº 13.709, de 14 de agosto de 2018. Lei Geral de Proteção de Dados Pessoais (LGPD). Diário Oficial da União, Brasília, DF, 2018. Disponível em: https://www.planalto.gov.br/ccivil_03/_ato2015-2018/2018/lei/l13709compilado.htm. Acesso em: 8 set. 2026.

ELETROGATE. Módulo regulador de tensão step-down LM2596. [S. l.], [s. d.]. Disponível em: https://www.eletrogate.com/modulo-regulador-de-tensao-step-down-lm2596. Acesso em: 30 ago. 2026.

ELETROGATE. Sensor de movimento e presença PIR. Disponível em: https://www.eletrogate.com/sensor-de-movimento-presenca-pir. Acesso em: 30 ago. 2026.

EVANS, D. The Internet of Things: How the Next Evolution of the Internet Is Changing Everything. Cisco Internet Business Solutions Group (IBSG), 2011.

FLESPI PLATFORM. HTTP vs MQTT performance tests. Medium, 2017. Disponível em: https://medium.com/@flespi/http-vs-mqtt-performance-tests-f9adde693b5f. Acesso em: 26 jan. 2026.

GEITGEY, Adam. face_recognition: the world's simplest facial recognition API for Python and the command line. GitHub, [s. d.]. Disponível em: https://github.com/ageitgey/face_recognition. Acesso em: 30 ago. 2026.

GONZALEZ, R. C.; WOODS, R. E. Processamento Digital de Imagens. 3. ed. São Paulo: Pearson Prentice Hall, 2010.

KING, Davis E. Dlib-ml: A Machine Learning Toolkit. Journal of Machine Learning Research, v. 10, p. 1755-1758, 2009.

RUSSELL, S. J.; Norvig, P. Artificial Intelligence: A Modern Approach. 3. ed. Upper Saddle River: Prentice Hall, 2010.

SCHROFF, F.; KALENICHENKO, D.; PHILBIN, J. FaceNet: A Unified Embedding for Face Recognition and Clustering. In: IEEE CONFERENCE ON COMPUTER VISION AND PATTERN RECOGNITION (CVPR), 2015, Boston. Proceedings [...]. Boston: IEEE, 2015. p. 815-823.

SZELISKI, Richard. Computer Vision: Algorithms and Applications. Springer Science & Business Media, 2010.

TICKNER, A. H.; POULTON, E. C. Monitoring surveillance pictures. Ergonomics, v. 16, n. 4, 1973.

VIOLA, P.; JONES, M. Rapid Object Detection using a Boosted Cascade of Simple Features. In: IEEE COMPUTER SOCIETY CONFERENCE ON COMPUTER VISION AND PATTERN RECOGNITION (CVPR), 2001, Kauai. Proceedings [...]. Kauai: IEEE, 2001. p. 511-518.
