joaovic-tech/IoT-Access-Control-ESP32/assets/20260830_223644.jpg

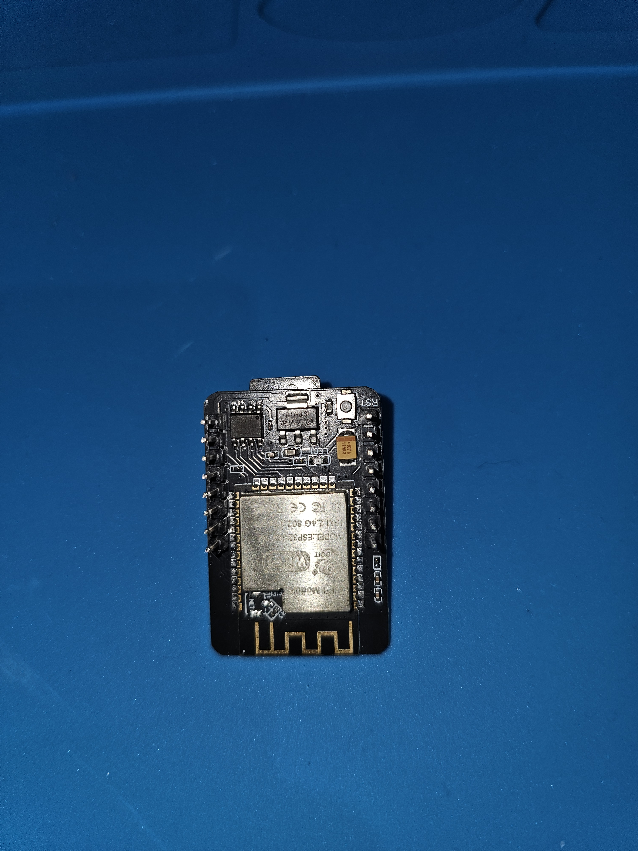
assets/20260830_223644.jpg
