joaovic-tech/IoT-Access-Control-ESP32/design-app-mobile/cadastrar-nova-pessoa.png

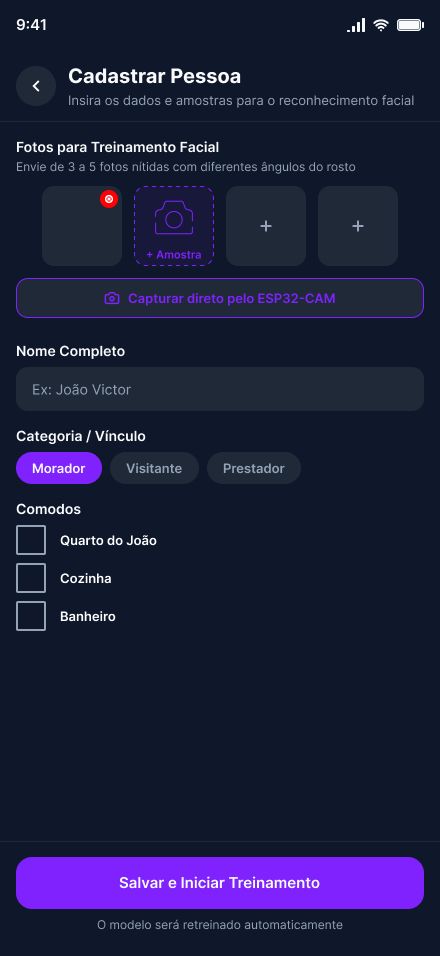
design-app-mobile/cadastrar-nova-pessoa.png
