joaovic-tech/IoT-Access-Control-ESP32/design-app-mobile/carrosel-rostos.png

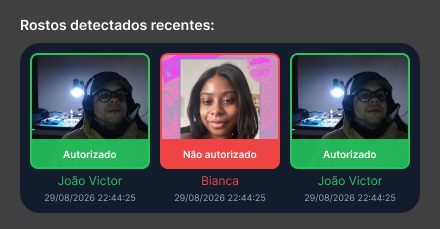
design-app-mobile/carrosel-rostos.png
