joaovic-tech/IoT-Access-Control-ESP32/design-app-mobile/dispositivos.png

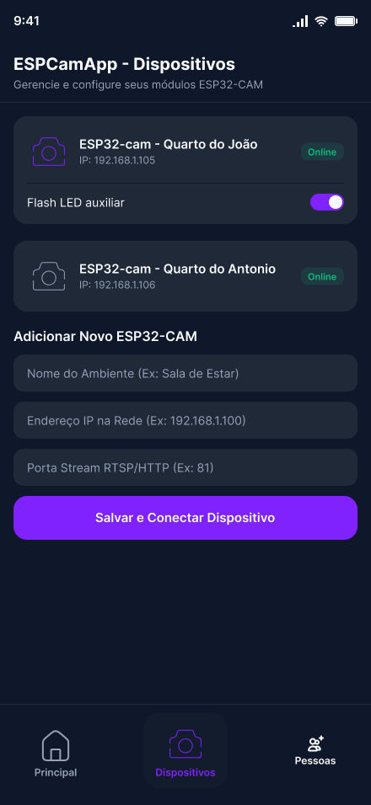
design-app-mobile/dispositivos.png
