joaovic-tech/IoT-Access-Control-ESP32/design-app-mobile/paletas de cores.png

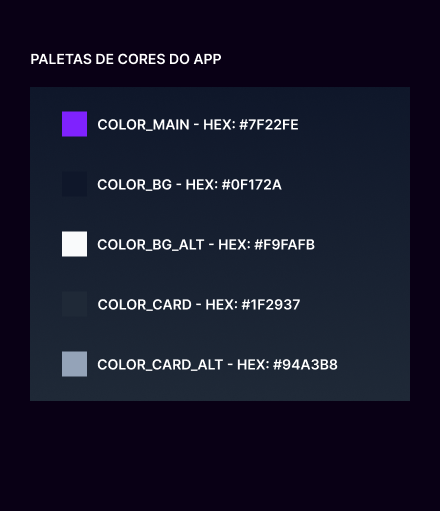
design-app-mobile/paletas de cores.png
