joaovic-tech/IoT-Access-Control-ESP32/code/DeviceCode/CameraWebServer.ino

//SciCraft
#include "esp_camera.h"
#include <WiFi.h>
#include <WiFiClientSecure.h>
#include <esp_timer.h>
#include <img_converters.h>
#include <Arduino.h>
#include "fb_gfx.h"
#include "camera_index.h"
#include "esp_http_server.h"

// Wi-Fi credentials
const char* ssid = "Lja";
const char* password = "lja98009890";

// Telegram bot
const char* botToken = "8591885212:AAG0GvES6gvC063fL8QpmkFgVSdV7ggDYko";
const char* chatID = "5024506585";

WiFiClientSecure clientTCP;

// PIR sensor
#define PIR_PIN 13
unsigned long lastMotionTime = 0;
const unsigned long motionCooldown = 15000; // 15 seconds

// Streaming support
#define CAMERA_MODEL_AI_THINKER
#include "camera_pins.h"
void startCameraServer(); // declared in camera_web_server.cpp (keep this in sketch folder)

void sendPhotoTelegram(camera_fb_t * fb) {
  if (WiFi.status() != WL_CONNECTED) return;

  clientTCP.stop();
  clientTCP.setInsecure();
  if (!clientTCP.connect("api.telegram.org", 443)) {
    Serial.println("Telegram connection failed");
    return;
  }
  String boundary = "ESP32CAMBOUNDARY";
  String startRequest = "--" + boundary + "\r\n";
  startRequest += "Content-Disposition: form-data; name=\"chat_id\"\r\n\r\n";
  startRequest += String(chatID) + "\r\n--" + boundary + "\r\n";
  startRequest += "Content-Disposition: form-data; name=\"caption\"\r\n\r\n";
  startRequest += "⚠️ Motion Detected!\r\n--" + boundary + "\r\n";
  startRequest += "Content-Disposition: form-data; name=\"photo\"; filename=\"image.jpg\"\r\n";
  startRequest += "Content-Type: image/jpeg\r\n\r\n";
  String endRequest = "\r\n--" + boundary + "--\r\n";

  int contentLength = startRequest.length() + fb->len + endRequest.length();

  String headers = "POST /bot" + String(botToken) + "/sendPhoto HTTP/1.1\r\n";
  headers += "Host: api.telegram.org\r\n";
  headers += "Content-Type: multipart/form-data; boundary=" + boundary + "\r\n";
  headers += "Content-Length: " + String(contentLength) + "\r\n\r\n";

  clientTCP.print(headers);
  clientTCP.print(startRequest);
  clientTCP.write(fb->buf, fb->len);
  clientTCP.print(endRequest);

  delay(500);
  while (clientTCP.connected()) {
    String line = clientTCP.readStringUntil('\n');
    if (line == "\r") break;
  }

  clientTCP.stop();
  Serial.println("📸 Photo sent to Telegram");
}

void setup() {
  Serial.begin(115200);
  pinMode(PIR_PIN, INPUT);

  WiFi.begin(ssid, password);
  WiFi.setSleep(false);
  while (WiFi.status() != WL_CONNECTED) {
    delay(500);
    Serial.print(".");
  }
  Serial.println("\nWiFi connected");

  camera_config_t config;
  config.ledc_channel = LEDC_CHANNEL_0;
  config.ledc_timer = LEDC_TIMER_0;
  config.pin_d0 = Y2_GPIO_NUM;
  config.pin_d1 = Y3_GPIO_NUM;
  config.pin_d2 = Y4_GPIO_NUM;
  config.pin_d3 = Y5_GPIO_NUM;
  config.pin_d4 = Y6_GPIO_NUM;
  config.pin_d5 = Y7_GPIO_NUM;
  config.pin_d6 = Y8_GPIO_NUM;
  config.pin_d7 = Y9_GPIO_NUM;
  config.pin_xclk = XCLK_GPIO_NUM;
  config.pin_pclk = PCLK_GPIO_NUM;
  config.pin_vsync = VSYNC_GPIO_NUM;
  config.pin_href = HREF_GPIO_NUM;
  config.pin_sccb_sda = SIOD_GPIO_NUM;
  config.pin_sccb_scl = SIOC_GPIO_NUM;
  config.pin_pwdn = PWDN_GPIO_NUM;
  config.pin_reset = RESET_GPIO_NUM;
  config.xclk_freq_hz = 20000000;
  config.pixel_format = PIXFORMAT_JPEG;
  config.frame_size = FRAMESIZE_QVGA;
  config.jpeg_quality = 20;
  config.fb_count = 2;
  config.fb_location = CAMERA_FB_IN_PSRAM;

  if (esp_camera_init(&config) != ESP_OK) {
    Serial.println("Camera init failed");
    return;
  }

  Serial.println("Camera Ready!");

  startCameraServer();

  Serial.print("Stream Link: http://");
  Serial.println(WiFi.localIP());
}

void loop() {
  if (digitalRead(PIR_PIN) == HIGH && millis() - lastMotionTime > motionCooldown) {
    camera_fb_t * fb = esp_camera_fb_get();

    lastMotionTime = millis();
    Serial.println("🚨 Motion detected!");

    
    if (!fb) {
      Serial.println("Camera capture failed");
      return;
    }
    
    sendPhotoTelegram(fb);
    esp_camera_fb_return(fb);
  }
}
