joaovic-tech/IoT-Access-Control-ESP32/(commit log)

2026-02-08 docs: update research notes and add sensor image
2026-02-09 docs(notes): update daily log with ESP32-CAM setup and initial test results
2026-02-10 docs(notes): reorganize 10/02 entry and add prototype images
    - Restructure daily note with clear sections (Resumo, O que fiz, Conexões, Protótipo Final)
    - Add wiring tables for Sensor PIR and ESP32-CAM-MB connections
    - Add prototype assembly images
2026-03-26 docs: update methodology and technical notes
    - Correct hardware terminology and technical definitions in the article
    - Adjust figure nomenclature to match visual content
    - Update ABNT citation formatting to upper case
    - Add technical analysis for latency and MQTT strategy to project notes
2026-03-26 docs: synchronize ABSTRACT with RESUMO terminology
    - Update hardware terminology to 'ESP32-CAM module' in both Portuguese and English sections
2026-03-28 docs(artigo): deliver stage 3 of the scientific article (3/5)
    - Synchronize article content with TCC_ALVES_Etapa3_2026.odt
    - Update bibliographic references and citations
    - Correct image filenames and paths in artigo.md and NOTE.md
    - Standardize section structure according to ABNT
2026-04-21 create a server for `IOT` and code device
2026-05-09 add code `device-to-telegramBot`
2026-08-30 feat(firmware): PIR envia captura ao servidor de faces e expõe /api/scan
    Relé movido do GPIO 12 (strapping pin) para o 14, segredos externalizados
    em arduino_secrets.h e /api/status com fps, stream_clients e has_psram.
    A captura no evento do PIR roda numa task FreeRTOS dedicada, com cooldown
    de 10 s, para não bloquear o stream.
2026-08-30 feat(server): servidor de reconhecimento facial com FastAPI e OpenCV
    Rotas /detect, /scan, /people, /enroll e /detections, com persistência em
    disco (known_faces/, people/, detections/ + sidecar JSON).
    Gira o quadro antes de reconhecer: o detector do dlib não encontra rosto de
    cabeça para baixo, o que fazia toda captura de uma câmera montada invertida
    retornar no_face. O ângulo vem da requisição (o app manda o cadastrado no
    dispositivo) ou do ROTATION no .env, usado no fluxo do PIR.
    Sem dlib instalado o servidor sobe em modo degradado: /health reporta
    engine_available: false e as rotas de reconhecimento respondem 503.
    38 testes com o motor facial substituído por um dublê.
    Co-Aut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
2026-08-30 feat(app): telas ligadas às APIs reais, player MJPEG e edição de dispositivos
    Move o projeto Android de code/app para code/ESPCamApp e liga as 4 telas às
    APIs reais (ViewModel + UiState por tela, DI manual em AppContainer, sem
    dados mock).
    Player MJPEG próprio com descarte de quadros atrasados, reconexão automática
    e giro de exibição por dispositivo (0/90/180/270) — o mesmo ângulo acompanha
    /scan e /enroll para o servidor reconhecer o quadro na vertical.
    Na aba Dispositivos: editar nome, IP e portas (a conexão só é testada quando
    o endereço muda) e escolher a orientação da câmera.
    Correções de integração encontradas em campo:
    - dois perfis de timeout — 8 s nas con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
2026-08-30 docs: README, contrato de API e tasks após a validação em campo
    README na raiz com arquitetura, execução e contrato de API; documenta o
    parâmetro rotation e o aviso de que o dlib não detecta rosto invertido.
    tasks.md reescrito: os fluxos D2-D5, que dependiam de hardware, foram
    validados na LAN com duas pessoas reais. Registra as lacunas encontradas
    no caminho (câmera invertida, timeout curto, lista sem refresh) e a
    configuração desta instalação.
    Inclui CLAUDE.md, o registro do dia em docs/NOTE.md e os mockups das telas.
2026-08-30 feat: cômodos por pessoa, edição do cadastro e cadastro mais rápido
    Os campos da pessoa passam a ser foto, nome, categoria/vínculo e os cômodos
    autorizados, como no design `cadastrar-nova-pessoa.png`. Os cômodos ficam na
    própria pessoa: o nível de acesso intermediário (levels_store, rotas /levels e
    a seção de níveis no app) saiu, porque a tela marca cômodo por cômodo. Cadastros
    antigos migram sozinhos — o nome do nível vira a categoria e os cômodos do nível
    vão para a pessoa.
    - servidor: GET /categories; `category` e `rooms` em POST/PATCH /people;
    access_control decide pela lista da própria pessoa (fecha por padrão)
    - app: tela Cadastrar/Editar Pessoa conforme o des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
2026-08-30 fix: LED que apagava sozinho, cômodos que não apareciam e a etiqueta "Pendente"
    As quatro pendências de tasks.md.
    O flash apagava ao trocar para a tela Principal porque o firmware tem dois
    estados de LED: setFlashLed() (/api/flash, usado pelo app) guarda g_flash_duty,
    enquanto enable_led() usa led_duty — variável separada que só o slider da página
    web escreve, e que vale 0 por padrão. Abrir o stream chamava enable_led(true) e
    reaplicava esse 0, apagando o LED; o app seguia mostrando o switch ligado porque
    g_flash_state continuava true. enable_led() passa a tratar o flash contínuo como
    estado persistente, e o slider da web altera esse estado quando ele está aceso.
    Cômodo novo n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
2026-08-30 docs: anotações de 30/08 e regra da pasta docs/ em CLAUDE.md
    Entrada do diário sobre cômodos na ficha da pessoa, edição do cadastro e as
    duas causas da lentidão ao cadastrar/apagar.
    docs/docs.md vira docs/CLAUDE.md, com o mesmo conteúdo: é o arquivo que os
    assistentes carregam automaticamente ao entrar no diretório.
    Claude-Session: https://claude.ai/code/session_011F7fJUStBnfDqMKe3nCjdW
2026-08-30 fix: fotos recusadas no cadastro sumiam sem explicação
    O app enviava as 5 fotos corretamente (confirmado com o servidor
    instrumentado), mas o detector HOG do dlib só encontra rosto de frente:
    perfil, queixo erguido e cabeça baixa voltam com "0 rosto(s) encontrados"
    em qualquer resolução e em qualquer rotação. Como a tela voltava para a
    lista assim que o servidor respondia, o bloco de avisos que já existia
    nunca aparecia — a pessoa ficava com menos amostras do que o usuário
    escolheu, sem nenhuma explicação.
    Servidor: `_store_samples` passa a devolver `refused` (arquivo, rostos e
    motivo) por amostra recusada; `warnings` continua no formato antigo.
    App: com alguma foto recusada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
