joaovic-tech/IoT-Access-Control-ESP32/(notices)

Notices in the files:
README.md:
License: GPLv3
